davefiddes/Wugo-PCII-System-Board/pictures/system-board-back-high-res.jpeg

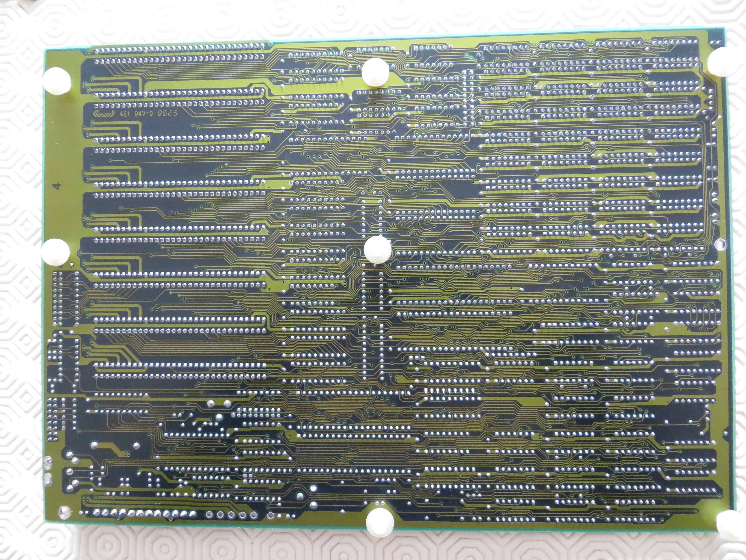
pictures/system-board-back-high-res.jpeg
