davefiddes/Wugo-PCII-System-Board/pictures/system-board-details-high-res.jpeg

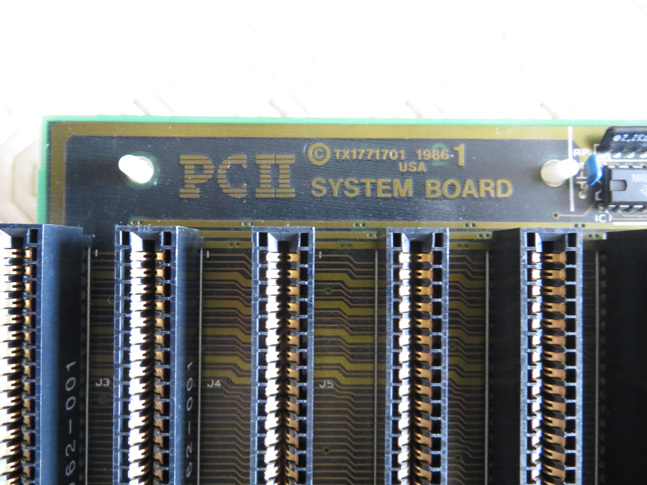
pictures/system-board-details-high-res.jpeg
