davefiddes/Wugo-PCII-System-Board/bus-arbitration.sch

## KiCad design bus-arbitration.sch (2020-07-20)

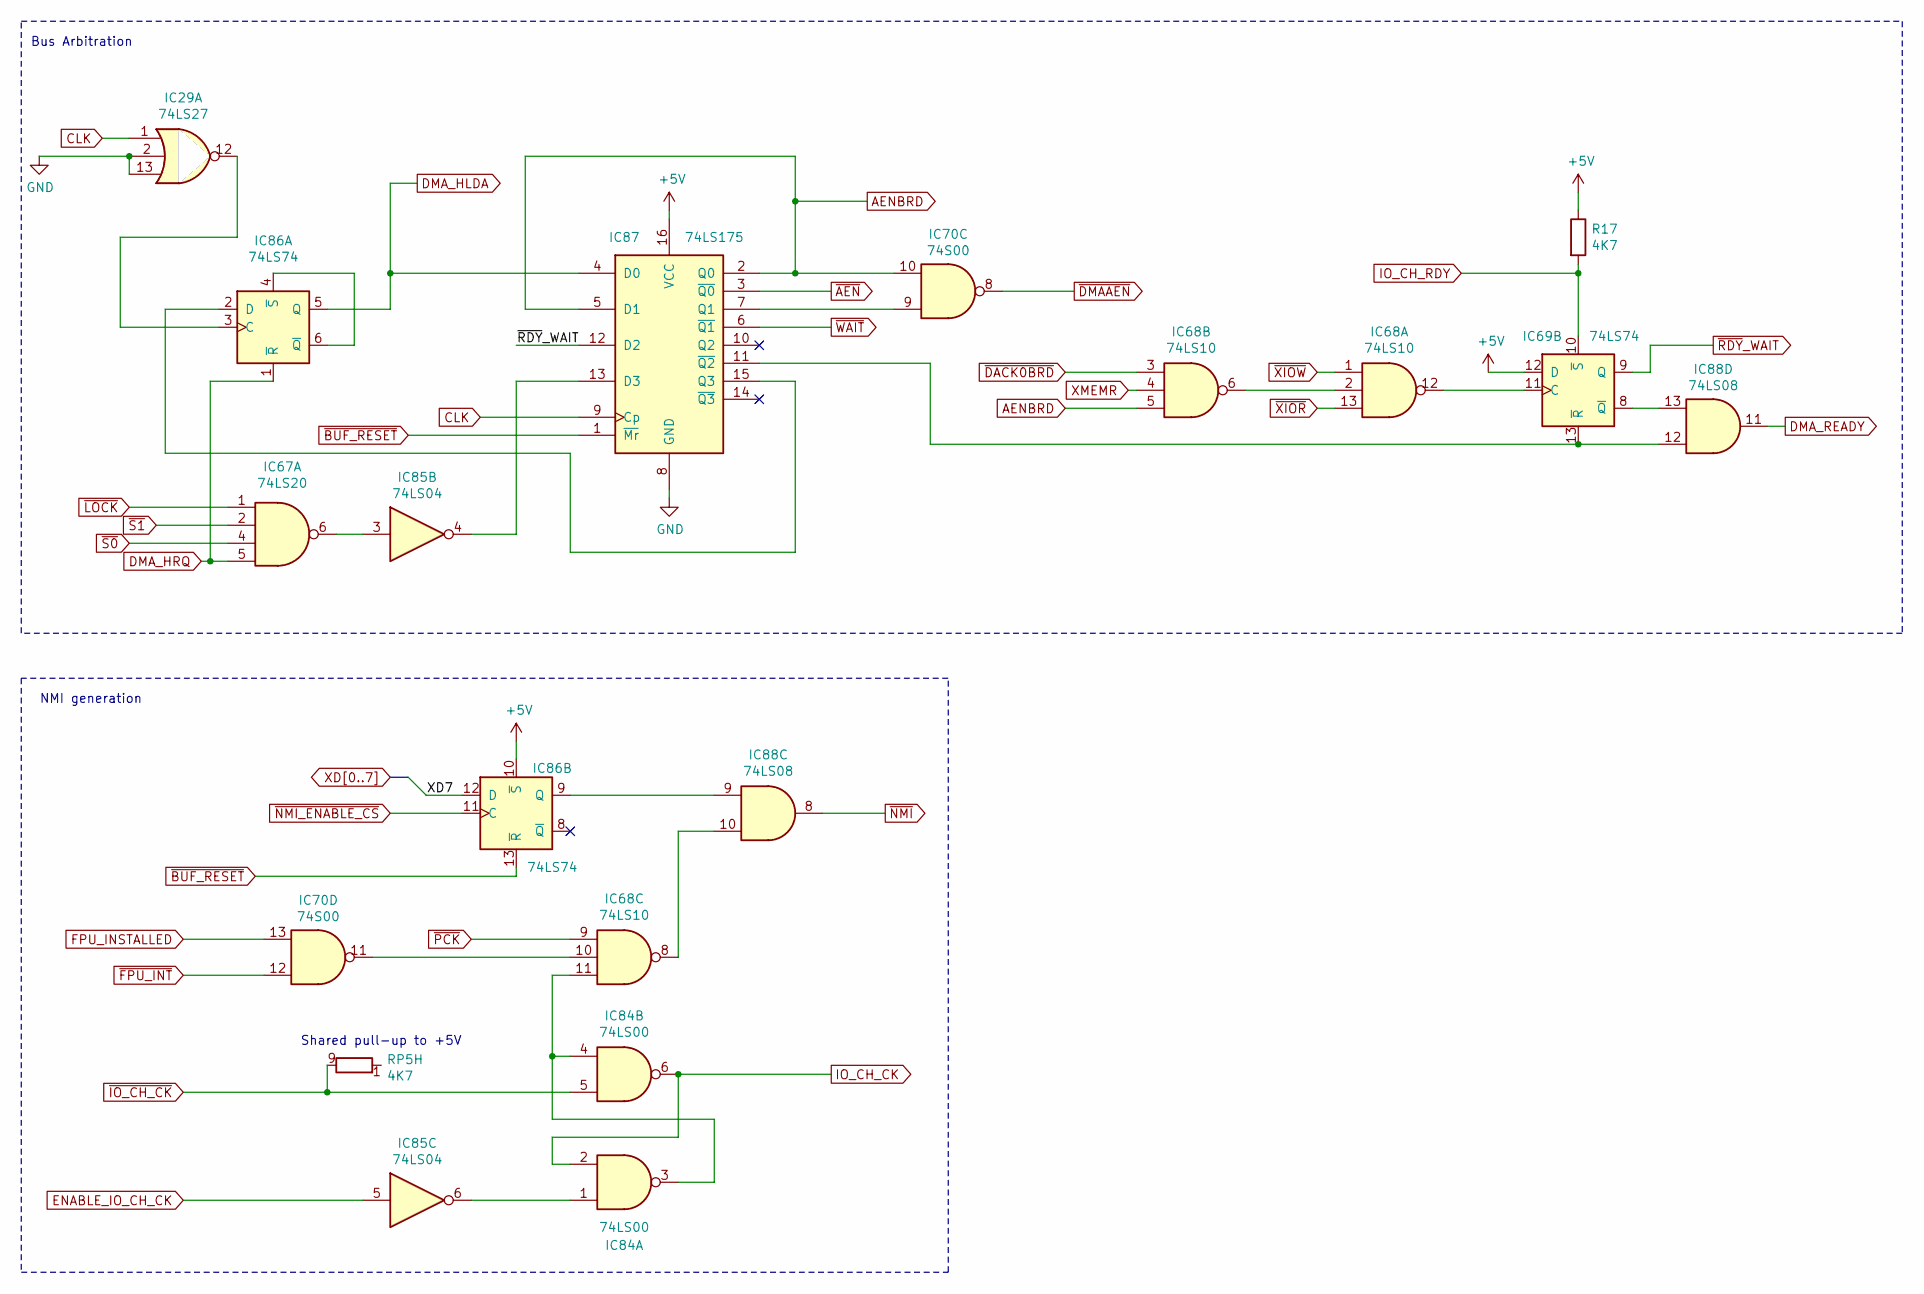
[picture p5: schematic bus-arbitration.sch]

Parts:
IC29: 74LS27
IC67: 74LS20
IC68: 74LS10
IC69, IC86: 74LS74
IC70: 74S00
IC84: 74LS00
IC85: 74LS04
IC87: 74LS175
IC88: 74LS08
R17: 4K7
RP5: 4K7; R_Array_SIP9

Connections:
+5V: IC69.12 (D), IC86.10 (~S), IC87.16 (VCC), R17.1
AENBRD: IC68.5, IC70.10, IC87.2 (Q0), IC87.5 (D1)
CLK: IC29.1, IC87.9 (Cp)
DMA_HLDA: IC86.5 (Q), IC87.4 (D0)
DMA_HRQ: IC67.5, IC86.1 (~R)
DMA_READY: IC88.11
ENABLE_IO_CH_CK: IC85.5
FPU_INSTALLED: IC70.13
GND: IC29.2, IC29.13, IC87.8 (GND)
IO_CH_CK: IC84.2, IC84.6
IO_CH_RDY: IC69.10 (~S), R17.2
unnamed: IC29.12, IC86.3 (C)
unnamed: IC67.6, IC85.3
unnamed: IC68.2, IC68.6
unnamed: IC68.8, IC88.10
unnamed: IC68.10, IC70.11
unnamed: IC68.11, IC84.3, IC84.4
unnamed: IC68.12, IC69.11 (C)
unnamed: IC69.8 (~Q), IC88.13
unnamed: IC69.13 (~R), IC87.11 (~Q2), IC88.12
unnamed: IC70.9, IC87.7 (Q1)
unnamed: IC84.1, IC85.6
unnamed: IC85.4, IC87.13 (D3)
unnamed: IC86.2 (D), IC87.15 (Q3)
unnamed: IC86.4 (~S), IC86.6 (~Q)
unnamed: IC86.9 (Q), IC88.9
XD7: IC86.12 (D)
XMEMR: IC68.4
~AEN~: IC87.3 (~Q0)
~BUF_RESET~: IC86.13 (~R), IC87.1 (~Mr)
~DACK0BRD~: IC68.3
~DMAAEN~: IC70.8
~FPU_INT~: IC70.12
~IO_CH_CK~: IC84.5, RP5.9 (R8.2)
~LOCK~: IC67.1
~NMI_ENABLE_CS~: IC86.11 (C)
~NMI~: IC88.8
~PCK~: IC68.9
~RDY~_WAIT: IC69.9 (Q), IC87.12 (D2)
~S0~: IC67.4
~S1~: IC67.2
~WAIT~: IC87.6 (~Q1)
~XIOR~: IC68.13
~XIOW~: IC68.1

Notes on the sheet:
NMI generation
Bus Arbitration
Shared pull-up to +5V
