davefiddes/Wugo-PCII-System-Board/clock.sch

## KiCad design clock.sch (2020-07-20)

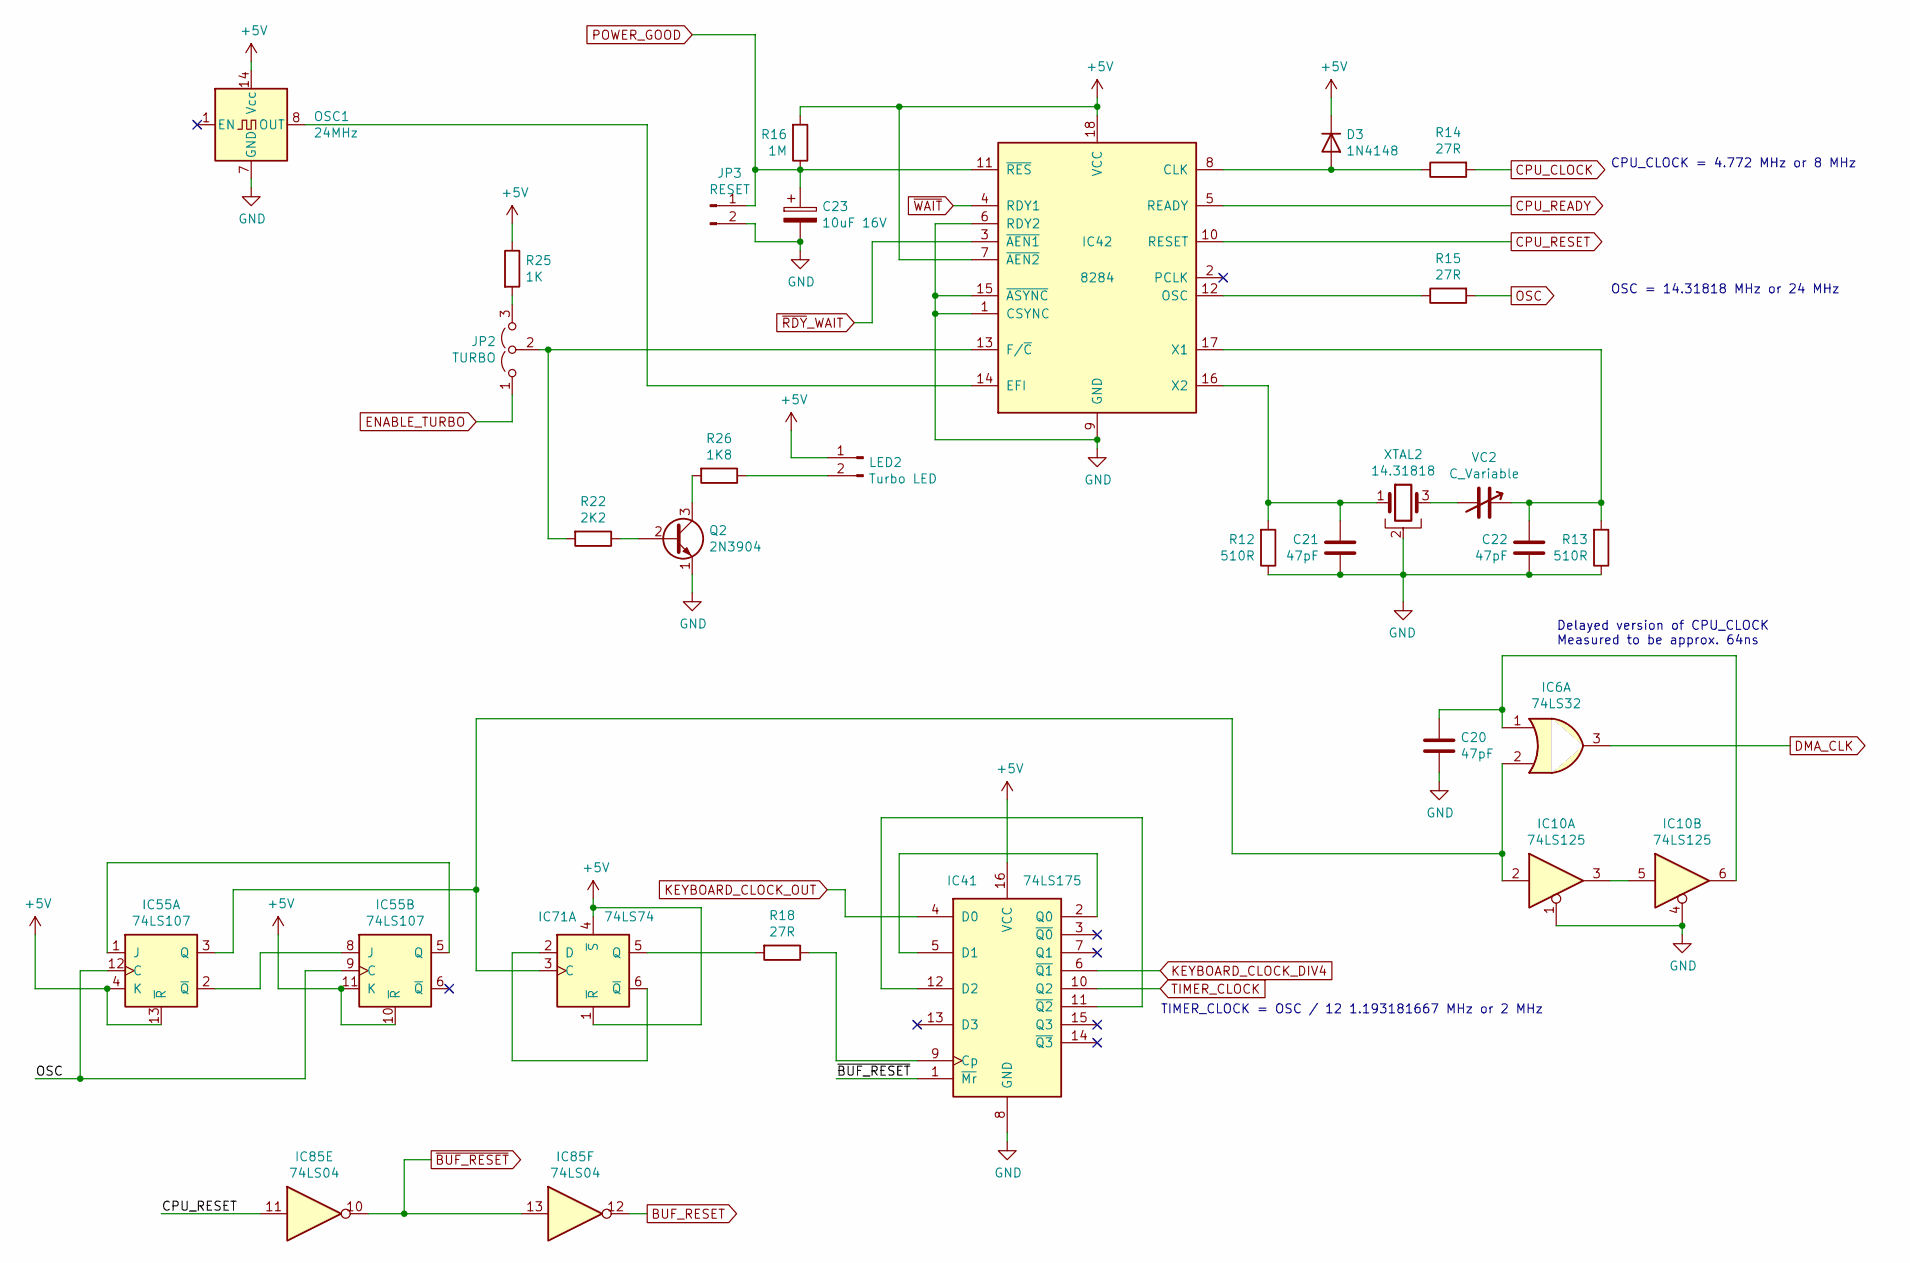
[picture p6: schematic clock.sch]

Parts:
C20, C21, C22: 47pF
C23: 10uF 16V
D3: 1N4148
IC6: 74LS32
IC10: 74LS125
IC41: 74LS175
IC42: 8284; DIP-18_W7.62mm
IC55: 74LS107
IC71: 74LS74
IC85: 74LS04
JP2: TURBO
JP3: RESET
LED2: Turbo LED
OSC1: 24MHz; Oscillator_DIP-14
Q2: 2N3904; TO-92_Inline
R12, R13: 510R
R14, R15, R18: 27R
R16: 1M
R22: 2K2
R25: 1K
R26: 1K8
VC2: C_Variable
XTAL2: 14.31818

Connections:
+5V: D3.1 (K), IC41.16 (VCC), IC42.7 (~AEN2~), IC42.18 (VCC), IC55.4 (K), IC55.10 (~R), IC55.11 (K), IC55.13 (~R), IC71.1 (~R), IC71.4 (~S), LED2.1, OSC1.14 (Vcc), R16.2, R25.1
BUF_RESET: IC85.12
CPU_CLOCK: R14.2
CPU_READY: IC42.5 (READY)
CPU_RESET: IC42.10 (RESET), IC85.11
DMA_CLK: IC6.3
ENABLE_TURBO: JP2.1 (A)
GND: C20.2, C21.2, C22.2, C23.2, IC10.1, IC10.4, IC41.8 (GND), IC42.1 (CSYNC), IC42.6 (RDY2), IC42.9 (GND), IC42.15 (~ASYNC~), JP3.2, OSC1.7 (GND), Q2.1 (E), R12.1, R13.1, XTAL2.2
KEYBOARD_CLOCK_DIV4: IC41.6 (~Q1)
KEYBOARD_CLOCK_OUT: IC41.4 (D0)
unnamed: C20.1, IC6.1, IC10.6
unnamed: C21.1, IC42.16 (X2), R12.2, XTAL2.1
unnamed: C22.1, IC42.17 (X1), R13.2, VC2.1
unnamed: D3.2 (A), IC42.8 (CLK), R14.1
unnamed: IC6.2, IC10.2, IC55.3 (Q), IC71.3 (C)
unnamed: IC10.3, IC10.5
unnamed: IC41.2 (Q0), IC41.5 (D1)
unnamed: IC41.9 (Cp), R18.1
unnamed: IC41.11 (~Q2), IC41.12 (D2)
unnamed: IC42.12 (OSC), R15.1
unnamed: IC42.13 (F/~C~), JP2.2 (C), R22.2
unnamed: IC42.14 (EFI), OSC1.8 (OUT)
unnamed: IC55.1 (J), IC55.5 (Q)
unnamed: IC55.2 (~Q), IC55.8 (J)
unnamed: IC71.2 (D), IC71.6 (~Q)
unnamed: IC71.5 (Q), R18.2
unnamed: JP2.3 (B), R25.2
unnamed: LED2.2, R26.1
unnamed: Q2.2 (B), R22.1
unnamed: Q2.3 (C), R26.2
unnamed: VC2.2, XTAL2.3
OSC: IC55.9 (C), IC55.12 (C), R15.2
POWER_GOOD: C23.1, IC42.11 (~RES~), JP3.1, R16.1
TIMER_CLOCK: IC41.10 (Q2)
~BUF_RESET~: IC41.1 (~Mr), IC85.10, IC85.13
~RDY~_WAIT: IC42.3 (~AEN1~)
~WAIT~: IC42.4 (RDY1)

Notes on the sheet:
TIMER_CLOCK = OSC / 12 1.193181667 MHz or 2 MHz
Delayed version of CPU_CLOCK Measured to be approx. 64ns
CPU_CLOCK = 4.772 MHz or 8 MHz
OSC = 14.31818 MHz or 24 MHz
