davefiddes/Wugo-PCII-System-Board/cpu.sch

## KiCad design cpu.sch (2020-07-20)

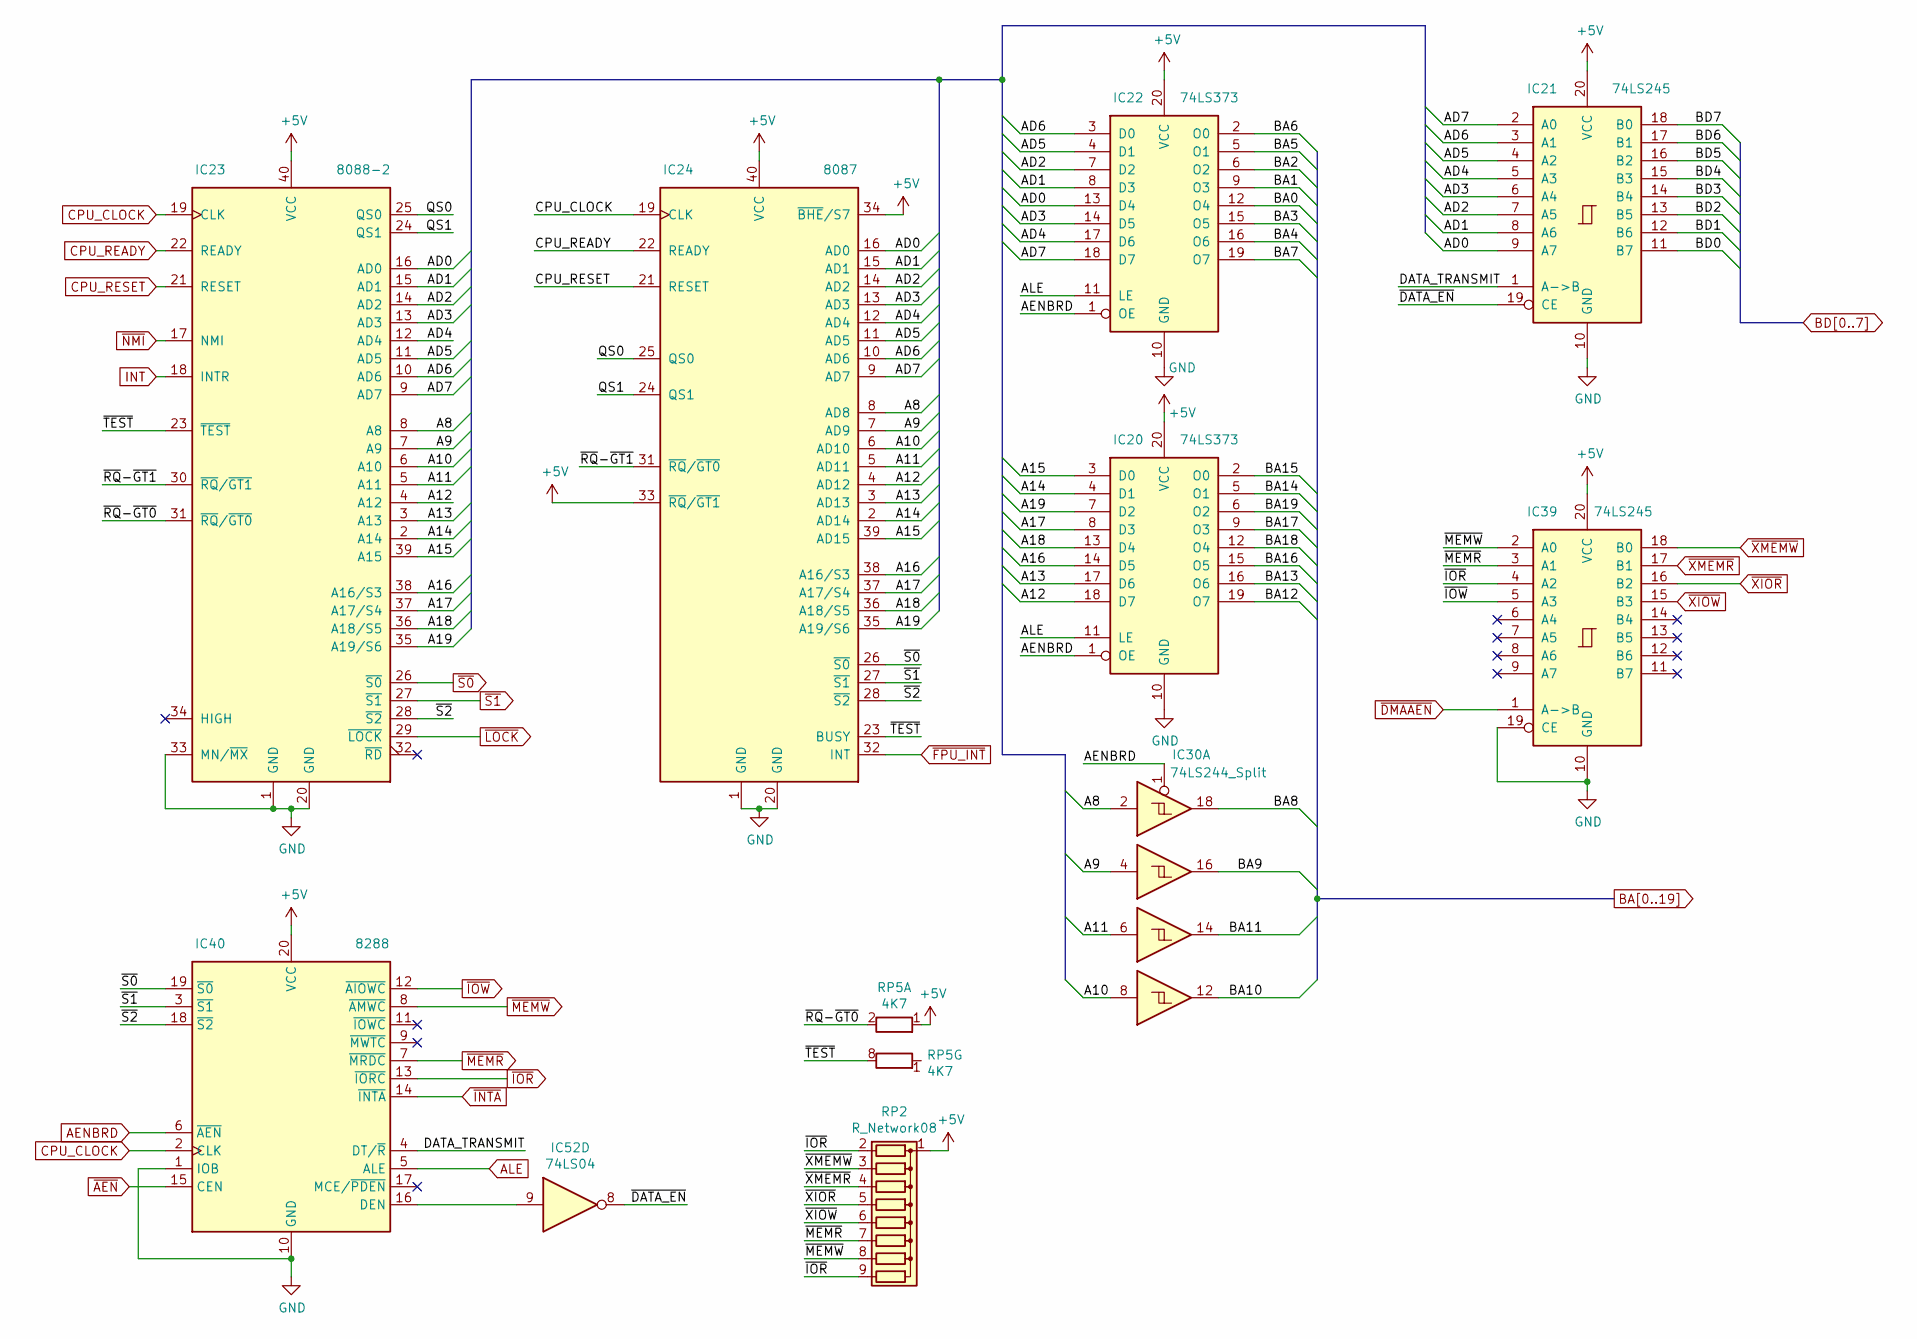
[picture p7: schematic cpu.sch]

Parts:
IC20, IC22: 74LS373
IC21, IC39: 74LS245
IC23: 8088-2; DIP-40_W15.24mm
IC24: 8087; DIP-40_W15.24mm
IC30: 74LS244_Split
IC40: 8288; DIP-20_W7.62mm
IC52: 74LS04
RP2: R_Network08; R_Array_SIP9
RP5: 4K7; R_Array_SIP9

Connections:
+5V: IC20.20 (VCC), IC21.20 (VCC), IC22.20 (VCC), IC23.40 (VCC), IC24.33 (~RQ~/~GT1~), IC24.34 (~BHE~/S7), IC24.40 (VCC), IC39.20 (VCC), IC40.20 (VCC), RP2.1 (common), RP5.1 (R1.1)
A8: IC23.8 (A8), IC24.8 (AD8), IC30.2
A9: IC23.7 (A9), IC24.7 (AD9), IC30.4
A10: IC23.6 (A10), IC24.6 (AD10), IC30.8
A11: IC23.5 (A11), IC24.5 (AD11), IC30.6
A12: IC20.18 (D7), IC23.4 (A12), IC24.4 (AD12)
A13: IC20.17 (D6), IC23.3 (A13), IC24.3 (AD13)
A14: IC20.4 (D1), IC23.2 (A14), IC24.2 (AD14)
A15: IC20.3 (D0), IC23.39 (A15), IC24.39 (AD15)
A16: IC20.14 (D5), IC23.38 (A16/S3), IC24.38 (A16/S3)
A17: IC20.8 (D3), IC23.37 (A17/S4), IC24.37 (A17/S4)
A18: IC20.13 (D4), IC23.36 (A18/S5), IC24.36 (A18/S5)
A19: IC20.7 (D2), IC23.35 (A19/S6), IC24.35 (A19/S6)
AD0: IC21.9 (A7), IC22.13 (D4), IC23.16 (AD0), IC24.16 (AD0)
AD1: IC21.8 (A6), IC22.8 (D3), IC23.15 (AD1), IC24.15 (AD1)
AD2: IC21.7 (A5), IC22.7 (D2), IC23.14 (AD2), IC24.14 (AD2)
AD3: IC21.6 (A4), IC22.14 (D5), IC23.13 (AD3), IC24.13 (AD3)
AD4: IC21.5 (A3), IC22.17 (D6), IC23.12 (AD4), IC24.12 (AD4)
AD5: IC21.4 (A2), IC22.4 (D1), IC23.11 (AD5), IC24.11 (AD5)
AD6: IC21.3 (A1), IC22.3 (D0), IC23.10 (AD6), IC24.10 (AD6)
AD7: IC21.2 (A0), IC22.18 (D7), IC23.9 (AD7), IC24.9 (AD7)
AENBRD: IC20.1 (OE), IC22.1 (OE), IC30.1, IC40.6 (~AEN~)
ALE: IC20.11 (LE), IC22.11 (LE), IC40.5 (ALE)
BA0: IC22.12 (O4)
BA1: IC22.9 (O3)
BA2: IC22.6 (O2)
BA3: IC22.15 (O5)
BA4: IC22.16 (O6)
BA5: IC22.5 (O1)
BA6: IC22.2 (O0)
BA7: IC22.19 (O7)
BA8: IC30.18
BA9: IC30.16
BA10: IC30.12
BA11: IC30.14
BA12: IC20.19 (O7)
BA13: IC20.16 (O6)
BA14: IC20.5 (O1)
BA15: IC20.2 (O0)
BA16: IC20.15 (O5)
BA17: IC20.9 (O3)
BA18: IC20.12 (O4)
BA19: IC20.6 (O2)
BD0: IC21.11 (B7)
BD1: IC21.12 (B6)
BD2: IC21.13 (B5)
BD3: IC21.14 (B4)
BD4: IC21.15 (B3)
BD5: IC21.16 (B2)
BD6: IC21.17 (B1)
BD7: IC21.18 (B0)
CPU_CLOCK: IC23.19 (CLK), IC24.19 (CLK), IC40.2 (CLK)
CPU_READY: IC23.22 (READY), IC24.22 (READY)
CPU_RESET: IC23.21 (RESET), IC24.21 (RESET)
DATA_TRANSMIT: IC21.1 (A->B), IC40.4 (DT/~R~)
GND: IC20.10 (GND), IC21.10 (GND), IC22.10 (GND), IC23.1 (GND), IC23.20 (GND), IC23.33 (MN/~MX~), IC24.1 (GND), IC24.20 (GND), IC39.10 (GND), IC39.19 (CE), IC40.1 (IOB), IC40.10 (GND)
INT: IC23.18 (INTR)
unnamed: IC40.16 (DEN), IC52.9
QS0: IC23.25 (QS0), IC24.25 (QS0)
QS1: IC23.24 (QS1), IC24.24 (QS1)
~AEN~: IC40.15 (CEN)
~DATA_EN~: IC21.19 (CE), IC52.8
~DMAAEN~: IC39.1 (A->B)
~FPU_INT~: IC24.32 (INT)
~INTA~: IC40.14 (~INTA~)
~IOR~: IC39.4 (A2), IC40.13 (~IORC~), RP2.2 (R1), RP2.9 (R8)
~IOW~: IC39.5 (A3), IC40.12 (~AIOWC~)
~LOCK~: IC23.29 (~LOCK~)
~MEMR~: IC39.3 (A1), IC40.7 (~MRDC~), RP2.7 (R6)
~MEMW~: IC39.2 (A0), IC40.8 (~AMWC~), RP2.8 (R7)
~NMI~: IC23.17 (NMI)
~RQ~-~GT0~: IC23.31 (~RQ~/~GT0~), RP5.2 (R1.2)
~RQ~-~GT1~: IC23.30 (~RQ~/~GT1~), IC24.31 (~RQ~/~GT0~)
~S0~: IC23.26 (~S0~), IC24.26 (~S0~), IC40.19 (~S0~)
~S1~: IC23.27 (~S1~), IC24.27 (~S1~), IC40.3 (~S1~)
~S2~: IC23.28 (~S2~), IC24.28 (~S2~), IC40.18 (~S2~)
~TEST~: IC23.23 (~TEST~), IC24.23 (BUSY), RP5.8 (R7.2)
~XIOR~: IC39.16 (B2), RP2.5 (R4)
~XIOW~: IC39.15 (B3), RP2.6 (R5)
~XMEMR~: IC39.17 (B1), RP2.4 (R3)
~XMEMW~: IC39.18 (B0), RP2.3 (R2)
