davefiddes/Wugo-PCII-System-Board/game-port.sch

## KiCad design game-port.sch (2020-07-20)

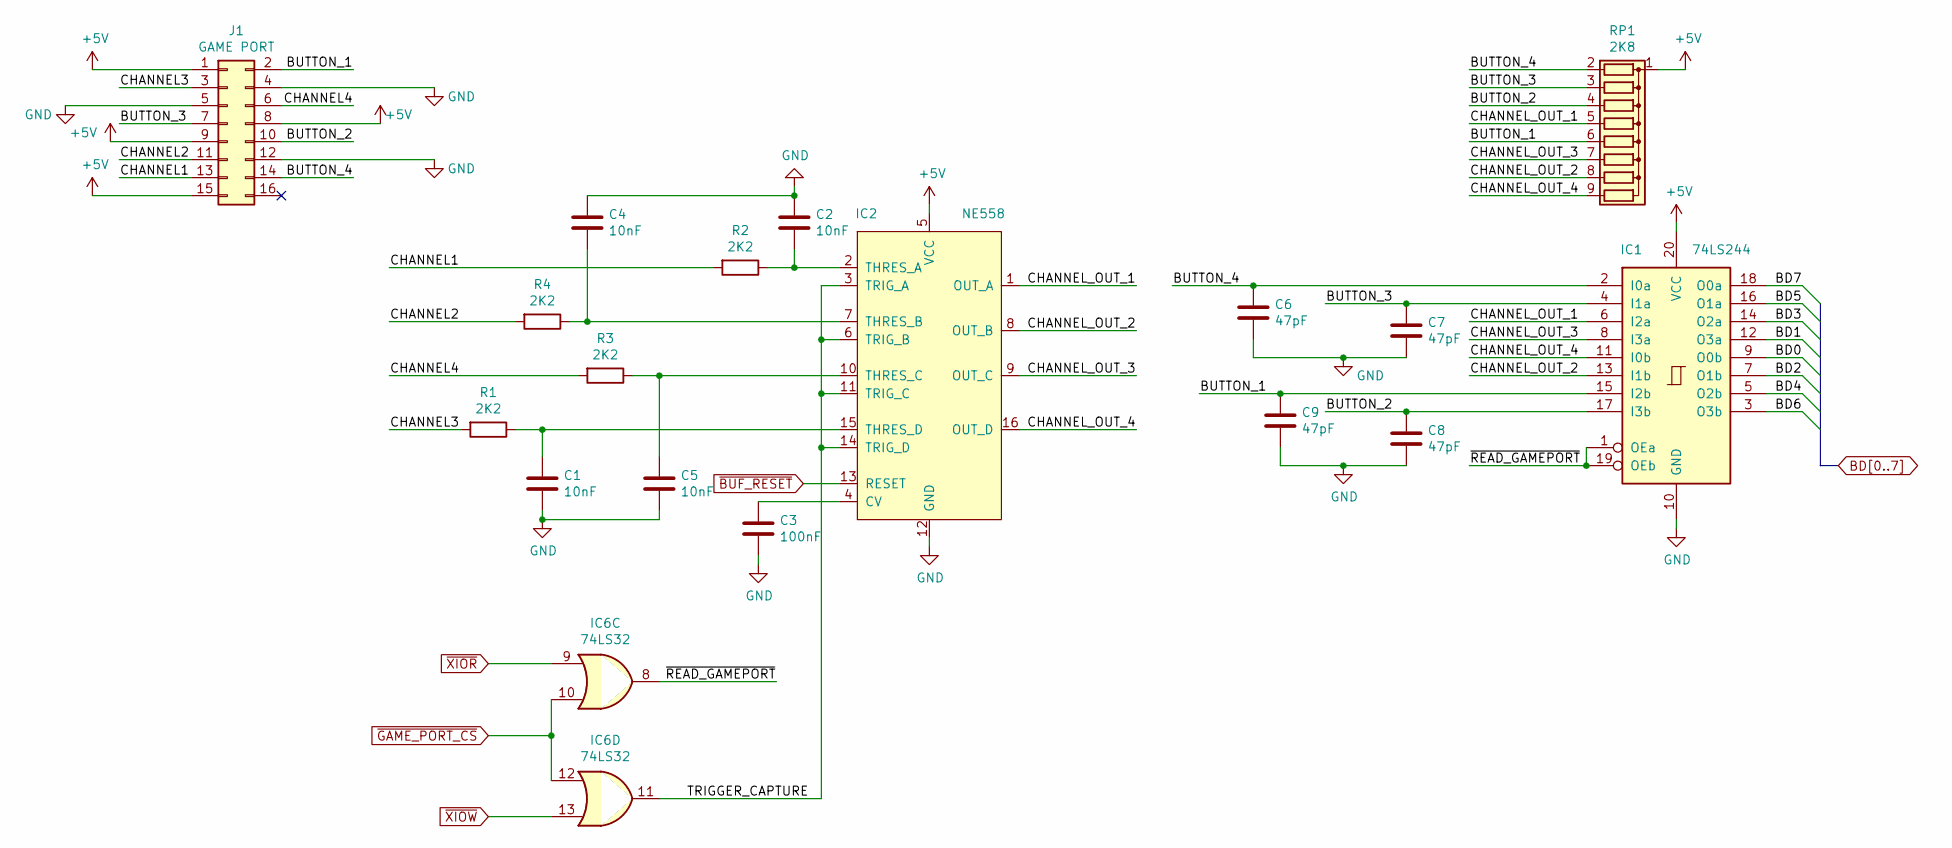
[picture p8: schematic game-port.sch]

Parts:
C1, C2, C4, C5: 10nF
C3: 100nF
C6, C7, C8, C9: 47pF
IC1: 74LS244
IC2: NE558
IC6: 74LS32
J1: GAME PORT
R1, R2, R3, R4: 2K2
RP1: 2K8; R_Array_SIP9

Connections:
+5V: IC1.20 (VCC), IC2.5 (VCC), J1.1, J1.8, J1.9, J1.15, RP1.1 (common)
BD0: IC1.9 (O0b)
BD1: IC1.12 (O3a)
BD2: IC1.7 (O1b)
BD3: IC1.14 (O2a)
BD4: IC1.5 (O2b)
BD5: IC1.16 (O1a)
BD6: IC1.3 (O3b)
BD7: IC1.18 (O0a)
BUTTON_1: C9.1, IC1.15 (I2b), J1.2, RP1.6 (R5)
BUTTON_2: C8.1, IC1.17 (I3b), J1.10, RP1.4 (R3)
BUTTON_3: C7.1, IC1.4 (I1a), J1.7, RP1.3 (R2)
BUTTON_4: C6.1, IC1.2 (I0a), J1.14, RP1.2 (R1)
CHANNEL1: J1.13, R2.2
CHANNEL2: J1.11, R4.2
CHANNEL3: J1.3, R1.2
CHANNEL4: J1.6, R3.2
CHANNEL_OUT_1: IC1.6 (I2a), IC2.1 (OUT_A), RP1.5 (R4)
CHANNEL_OUT_2: IC1.13 (I1b), IC2.8 (OUT_B), RP1.8 (R7)
CHANNEL_OUT_3: IC1.8 (I3a), IC2.9 (OUT_C), RP1.7 (R6)
CHANNEL_OUT_4: IC1.11 (I0b), IC2.16 (OUT_D), RP1.9 (R8)
GND: C1.2, C2.1, C3.2, C4.1, C5.2, C6.2, C7.2, C8.2, C9.2, IC1.10 (GND), IC2.12 (GND), J1.4, J1.5, J1.12
unnamed: C1.1, IC2.15 (THRES_D), R1.1
unnamed: C2.2, IC2.2 (THRES_A), R2.1
unnamed: C3.1, IC2.4 (CV)
unnamed: C4.2, IC2.7 (THRES_B), R4.1
unnamed: C5.1, IC2.10 (THRES_C), R3.1
TRIGGER_CAPTURE: IC2.3 (TRIG_A), IC2.6 (TRIG_B), IC2.11 (TRIG_C), IC2.14 (TRIG_D), IC6.11
~BUF_RESET~: IC2.13 (RESET)
~GAME_PORT_CS~: IC6.10, IC6.12
~READ_GAMEPORT~: IC1.1 (OEa), IC1.19 (OEb), IC6.8
~XIOR~: IC6.9
~XIOW~: IC6.13
