davefiddes/Wugo-PCII-System-Board/interrupts-dma.sch

## KiCad design interrupts-dma.sch (2020-07-20)

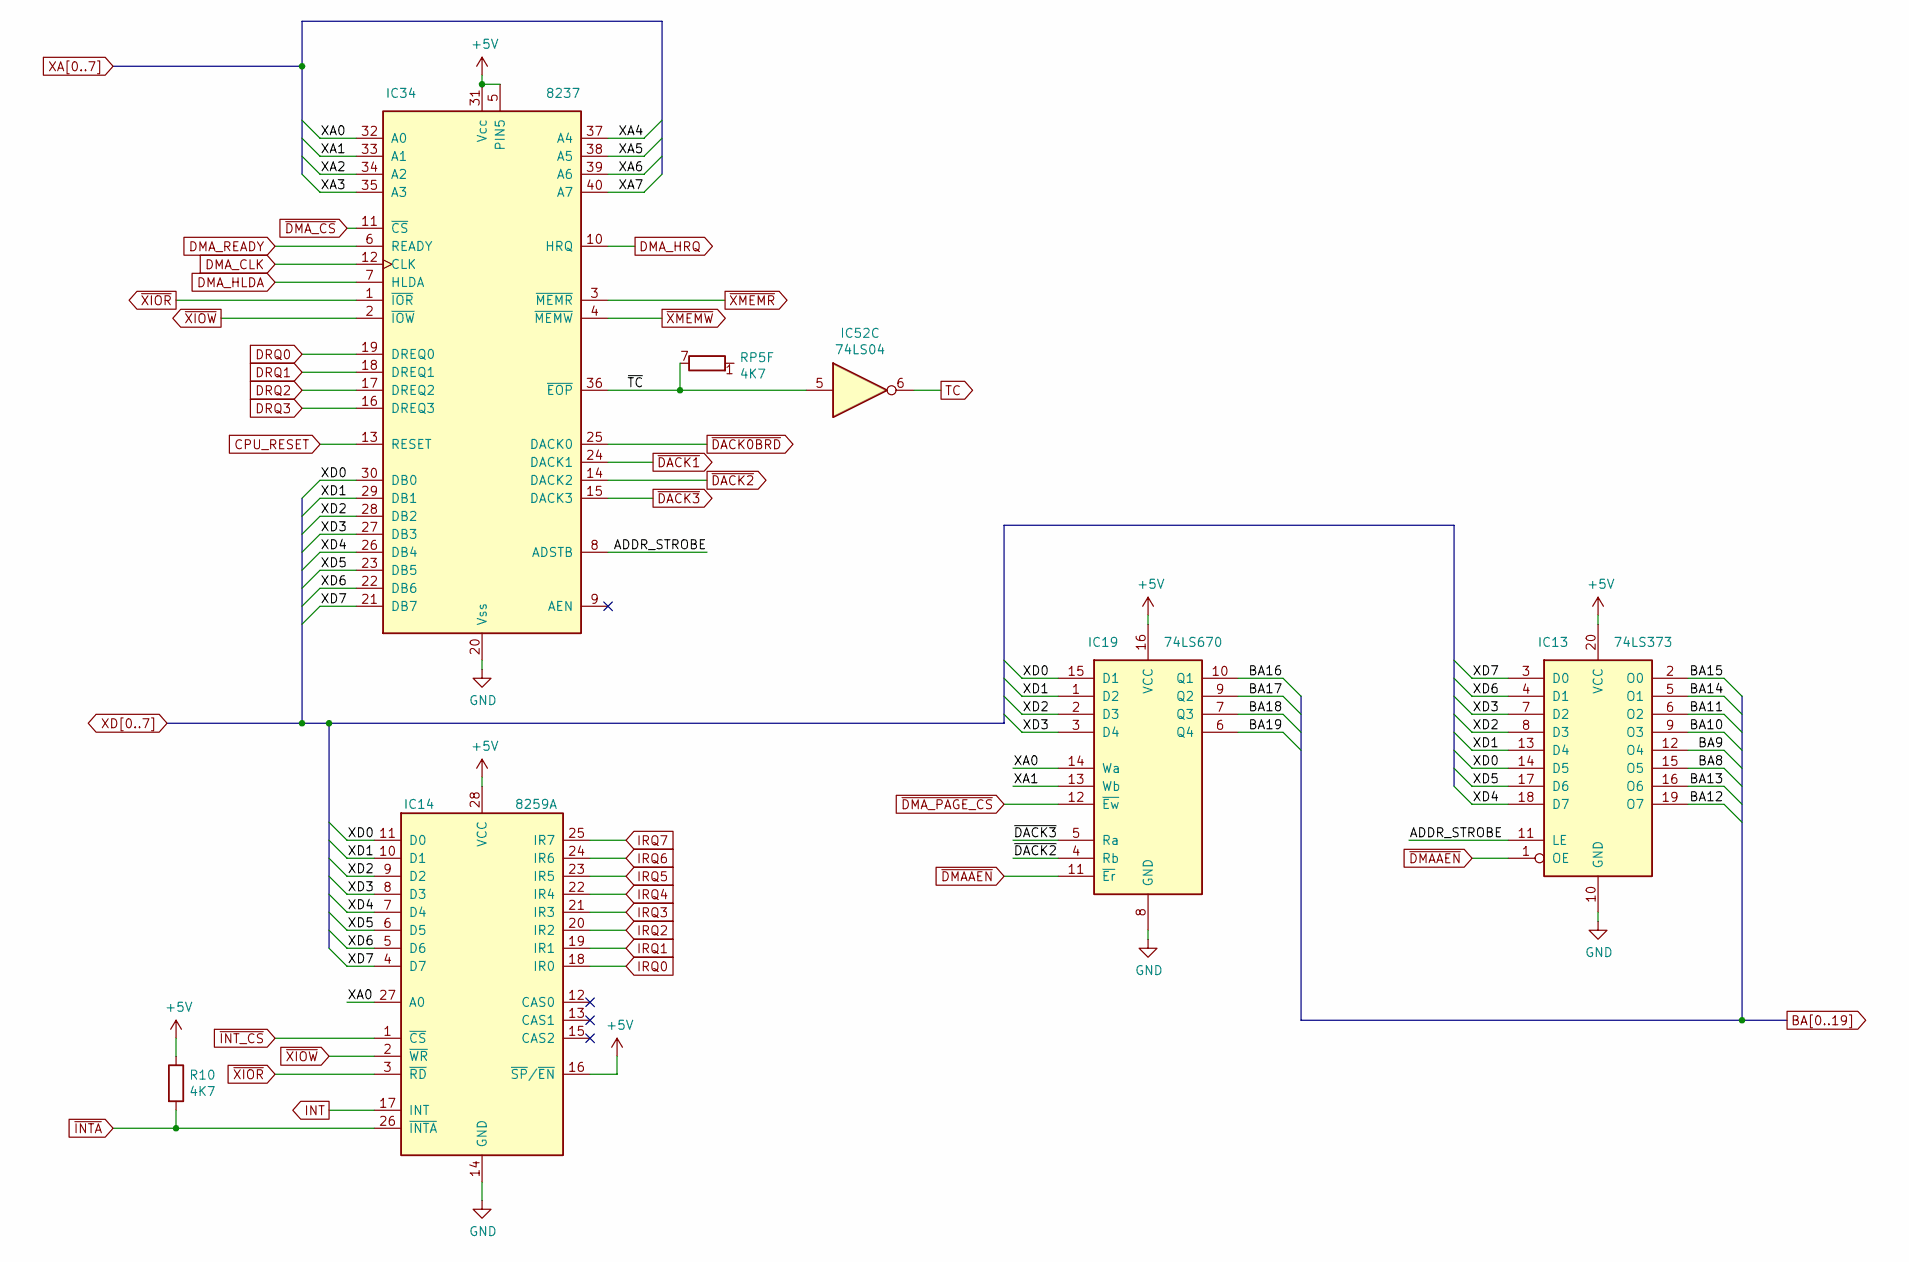
[picture p9: schematic interrupts-dma.sch]

Parts:
IC13: 74LS373
IC14: 8259A; DIP-28_W15.24mm
IC19: 74LS670
IC34: 8237; DIP-40_W15.24mm
IC52: 74LS04
R10: 4K7
RP5: 4K7; R_Array_SIP9

Connections:
+5V: IC13.20 (VCC), IC14.16 (~SP~/~EN~), IC14.28 (VCC), IC19.16 (VCC), IC34.5 (PIN5), IC34.31 (Vcc), R10.1
ADDR_STROBE: IC13.11 (LE), IC34.8 (ADSTB)
BA8: IC13.15 (O5)
BA9: IC13.12 (O4)
BA10: IC13.9 (O3)
BA11: IC13.6 (O2)
BA12: IC13.19 (O7)
BA13: IC13.16 (O6)
BA14: IC13.5 (O1)
BA15: IC13.2 (O0)
BA16: IC19.10 (Q1)
BA17: IC19.9 (Q2)
BA18: IC19.7 (Q3)
BA19: IC19.6 (Q4)
CPU_RESET: IC34.13 (RESET)
DMA_CLK: IC34.12 (CLK)
DMA_HLDA: IC34.7 (HLDA)
DMA_HRQ: IC34.10 (HRQ)
DMA_READY: IC34.6 (READY)
DRQ0: IC34.19 (DREQ0)
DRQ1: IC34.18 (DREQ1)
DRQ2: IC34.17 (DREQ2)
DRQ3: IC34.16 (DREQ3)
GND: IC13.10 (GND), IC14.14 (GND), IC19.8 (GND), IC34.20 (Vss)
INT: IC14.17 (INT)
IRQ0: IC14.18 (IR0)
IRQ1: IC14.19 (IR1)
IRQ2: IC14.20 (IR2)
IRQ3: IC14.21 (IR3)
IRQ4: IC14.22 (IR4)
IRQ5: IC14.23 (IR5)
IRQ6: IC14.24 (IR6)
IRQ7: IC14.25 (IR7)
TC: IC52.6
XA0: IC14.27 (A0), IC19.14 (Wa), IC34.32 (A0)
XA1: IC19.13 (Wb), IC34.33 (A1)
XA2: IC34.34 (A2)
XA3: IC34.35 (A3)
XA4: IC34.37 (A4)
XA5: IC34.38 (A5)
XA6: IC34.39 (A6)
XA7: IC34.40 (A7)
XD0: IC13.14 (D5), IC14.11 (D0), IC19.15 (D1), IC34.30 (DB0)
XD1: IC13.13 (D4), IC14.10 (D1), IC19.1 (D2), IC34.29 (DB1)
XD2: IC13.8 (D3), IC14.9 (D2), IC19.2 (D3), IC34.28 (DB2)
XD3: IC13.7 (D2), IC14.8 (D3), IC19.3 (D4), IC34.27 (DB3)
XD4: IC13.18 (D7), IC14.7 (D4), IC34.26 (DB4)
XD5: IC13.17 (D6), IC14.6 (D5), IC34.23 (DB5)
XD6: IC13.4 (D1), IC14.5 (D6), IC34.22 (DB6)
XD7: IC13.3 (D0), IC14.4 (D7), IC34.21 (DB7)
~DACK0BRD~: IC34.25 (DACK0)
~DACK1~: IC34.24 (DACK1)
~DACK2~: IC19.4 (Rb), IC34.14 (DACK2)
~DACK3~: IC19.5 (Ra), IC34.15 (DACK3)
~DMAAEN~: IC13.1 (OE), IC19.11 (~Er)
~DMA_CS~: IC34.11 (~CS~)
~DMA_PAGE_CS~: IC19.12 (~Ew)
~INTA~: IC14.26 (~INTA~), R10.2
~INT_CS~: IC14.1 (~CS~)
~TC~: IC34.36 (~EOP~), IC52.5, RP5.7 (R6.2)
~XIOR~: IC14.3 (~RD~), IC34.1 (~IOR~)
~XIOW~: IC14.2 (~WR~), IC34.2 (~IOW~)
~XMEMR~: IC34.3 (~MEMR~)
~XMEMW~: IC34.4 (~MEMW~)
