davefiddes/Wugo-PCII-System-Board/io-decode.sch

## KiCad design io-decode.sch (2020-05-30)

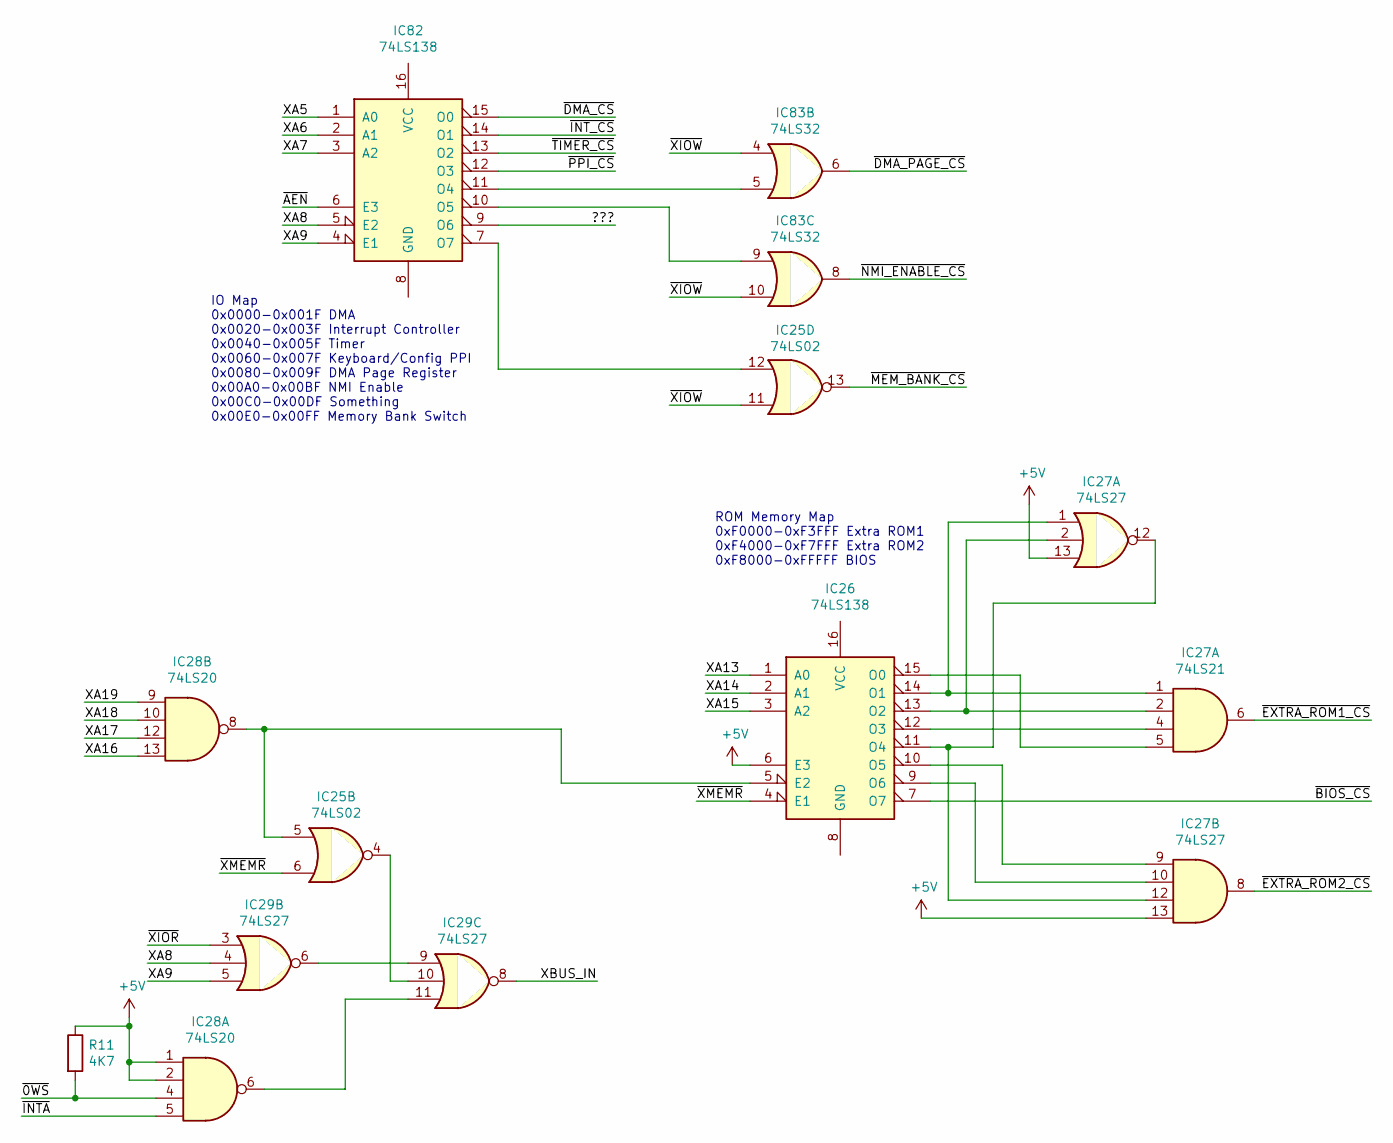
[picture p10: schematic io-decode.sch]

Parts:
IC25: 74LS02
IC26, IC82: 74LS138
IC27: 74LS21
IC28: 74LS20
IC29: 74LS27
IC83: 74LS32
R11: 4K7

Connections:
+5V: IC26.6 (E3), IC27.13, IC28.1, IC28.2, R11.1
???: IC82.9 (O6)
unnamed: IC25.4, IC29.10
unnamed: IC25.5, IC26.5 (E2), IC28.8
unnamed: IC25.12, IC82.7 (O7)
unnamed: IC26.9 (O6), IC27.10
unnamed: IC26.10 (O5), IC27.9
unnamed: IC26.11 (O4), IC27.12
unnamed: IC26.12 (O3), IC27.4
unnamed: IC26.13 (O2), IC27.2
unnamed: IC26.14 (O1), IC27.1
unnamed: IC26.15 (O0), IC27.5
unnamed: IC28.6, IC29.11
unnamed: IC29.6, IC29.9
unnamed: IC82.10 (O5), IC83.9
unnamed: IC82.11 (O4), IC83.5
XA5: IC82.1 (A0)
XA6: IC82.2 (A1)
XA7: IC82.3 (A2)
XA8: IC29.4, IC82.5 (E2)
XA9: IC29.5, IC82.4 (E1)
XA13: IC26.1 (A0)
XA14: IC26.2 (A1)
XA15: IC26.3 (A2)
XA16: IC28.13
XA17: IC28.12
XA18: IC28.10
XA19: IC28.9
XBUS_IN: IC29.8
~0WS~: IC28.4, R11.2
~AEN~: IC82.6 (E3)
~BIOS_CS~: IC26.7 (O7)
~DMA_CS~: IC82.15 (O0)
~DMA_PAGE_CS~: IC83.6
~EXTRA_ROM1_CS~: IC27.6
~EXTRA_ROM2_CS~: IC27.8
~INTA~: IC28.5
~INT_CS~: IC82.14 (O1)
~MEM_BANK_CS~: IC25.13
~NMI_ENABLE_CS~: IC83.8
~PPI_CS~: IC82.12 (O3)
~TIMER_CS~: IC82.13 (O2)
~XIOR~: IC29.3
~XIOW~: IC25.11, IC83.4, IC83.10
~XMEMR~: IC25.6, IC26.4 (E1)

Notes on the sheet:
ROM Memory Map 0xF0000-0xF3FFF Extra ROM1 0xF4000-0xF7FFF Extra ROM2 0xF8000-0xFFFFF BIOS
IO Map 0x0000-0x001F DMA 0x0020-0x003F Interrupt Controller 0x0040-0x005F Timer 0x0060-0x007F Keyboard/Config PPI 0x0080-0x009F DMA Page Register 0x00A0-0x00BF NMI Enable 0x00C0-0x00DF Something 0x00E0-0x00FF Memory Bank Switch
