davefiddes/Wugo-PCII-System-Board/io-rom-decode.sch

## KiCad design io-rom-decode.sch (2020-07-20)

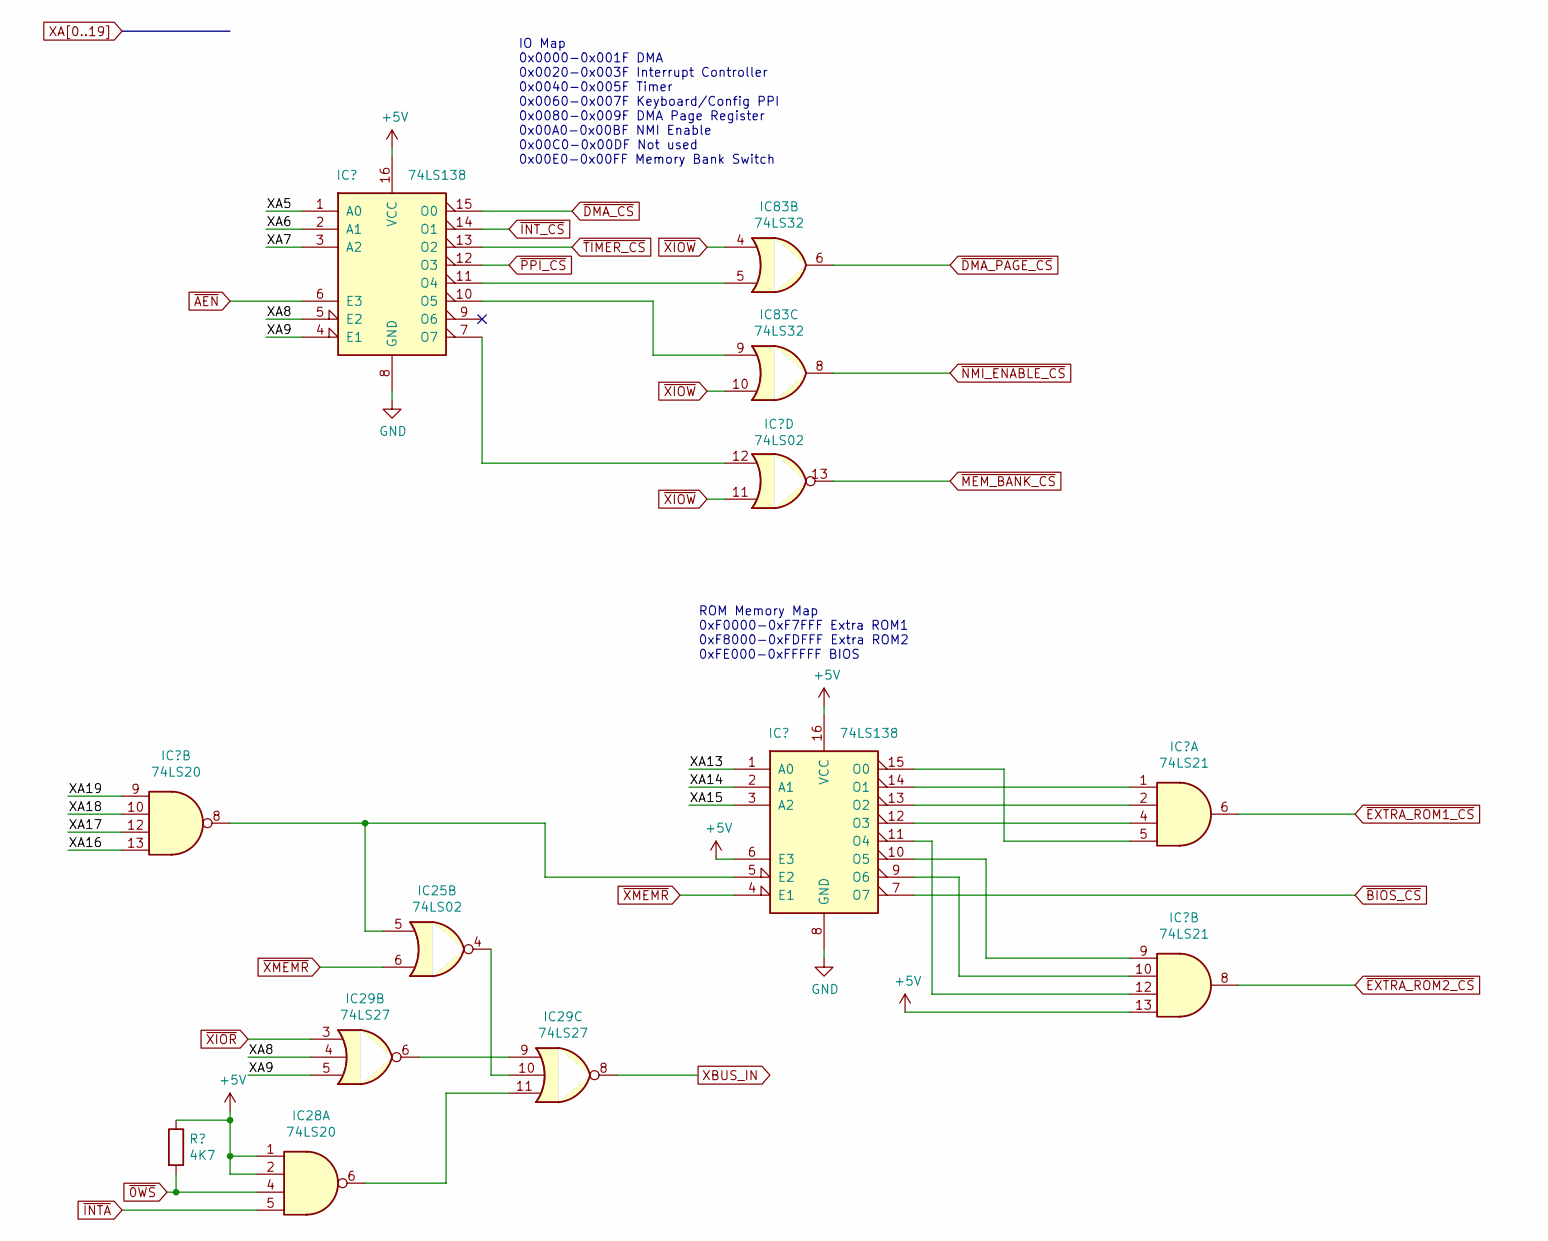
[picture p11: schematic io-rom-decode.sch]

Parts:
IC25: 74LS02
IC28: 74LS20
IC29: 74LS27
IC83: 74LS32

Connections:
+5V: IC28.1, IC28.2
unnamed: IC25.4, IC29.10
unnamed: IC28.6, IC29.11
unnamed: IC29.6, IC29.9
XA8: IC29.4
XA9: IC29.5
XBUS_IN: IC29.8
~0WS~: IC28.4
~DMA_PAGE_CS~: IC83.6
~INTA~: IC28.5
~NMI_ENABLE_CS~: IC83.8
~XIOR~: IC29.3
~XIOW~: IC83.4, IC83.10
~XMEMR~: IC25.6

Notes on the sheet:
ROM Memory Map 0xF0000-0xF7FFF Extra ROM1 0xF8000-0xFDFFF Extra ROM2 0xFE000-0xFFFFF BIOS
IO Map 0x0000-0x001F DMA 0x0020-0x003F Interrupt Controller 0x0040-0x005F Timer 0x0060-0x007F Keyboard/Config PPI 0x0080-0x009F DMA Page Register 0x00A0-0x00BF NMI Enable 0x00C0-0x00DF Not used 0x00E0-0x00FF Memory Bank Switch
