davefiddes/Wugo-PCII-System-Board/isa-bus.sch

## KiCad design isa-bus.sch (2020-07-20)

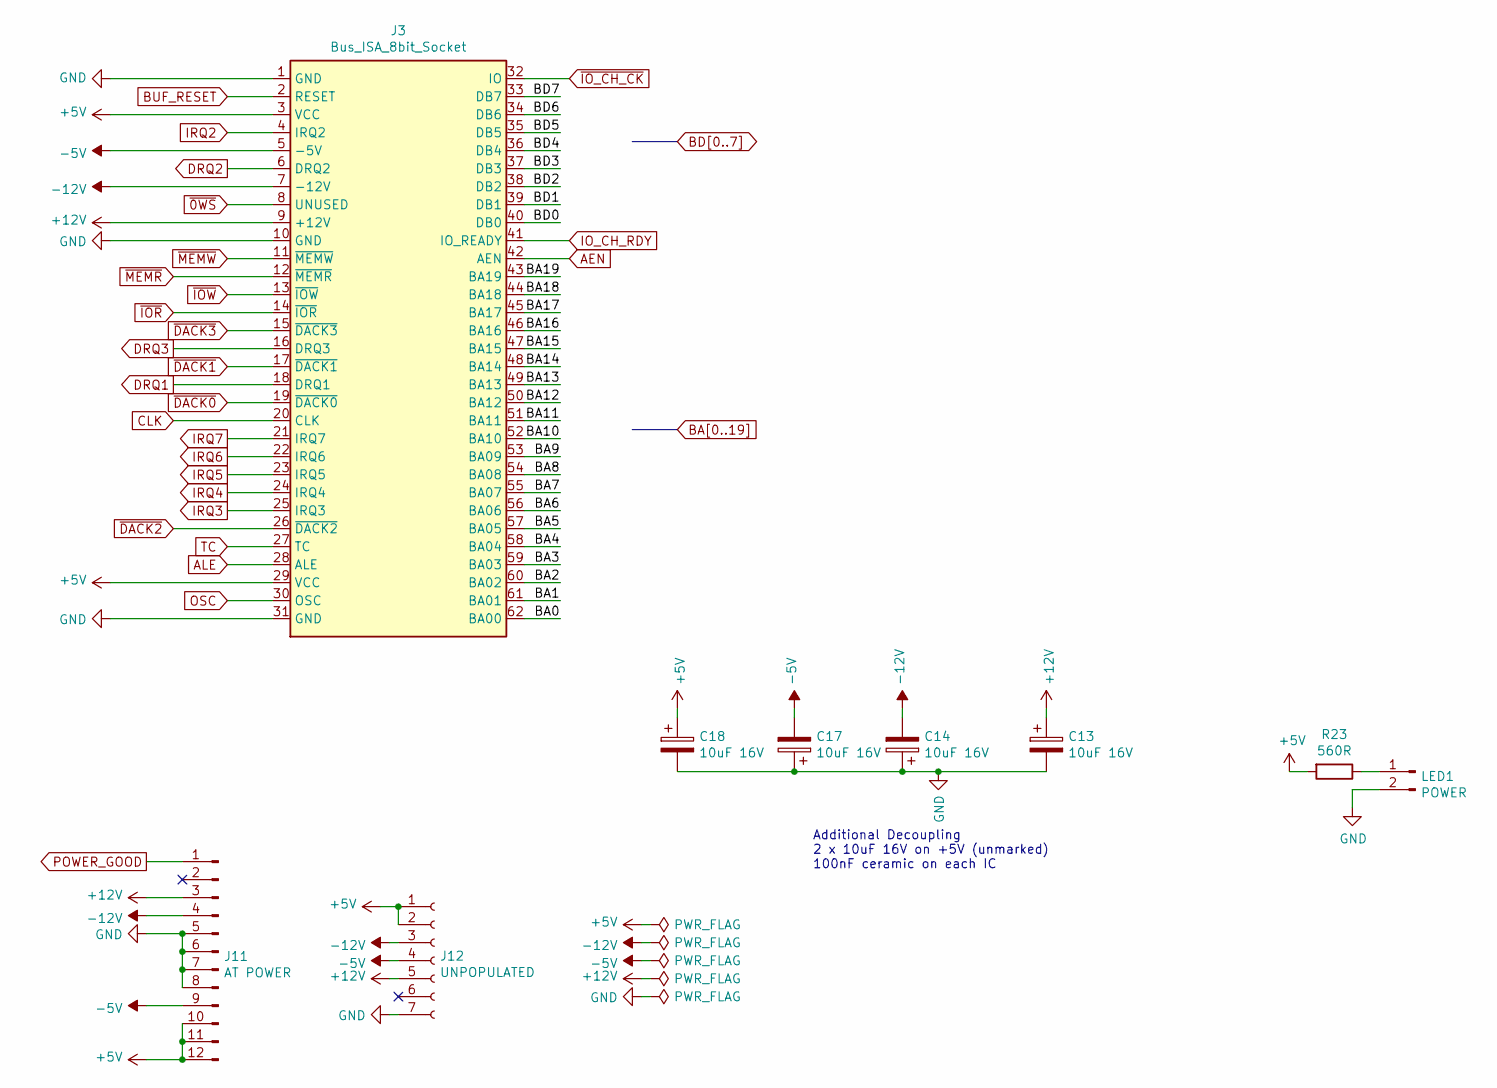
[picture p12: schematic isa-bus.sch]

Parts:
C13, C14, C17, C18: 10uF 16V
J3: Bus_ISA_8bit_Socket
J11: AT POWER
J12: UNPOPULATED
LED1: POWER
R23: 560R

Connections:
+5V: C18.1, J3.3 (VCC), J3.29 (VCC), J11.10, J11.11, J11.12, J12.1, J12.2, R23.2
+12V: C13.1, J3.9 (+12V), J11.3, J12.5
-5V: C17.2, J3.5 (-5V), J11.9, J12.4
-12V: C14.2, J3.7 (-12V), J11.4, J12.3
AEN: J3.42 (AEN)
ALE: J3.28 (ALE)
BA0: J3.62 (BA00)
BA1: J3.61 (BA01)
BA2: J3.60 (BA02)
BA3: J3.59 (BA03)
BA4: J3.58 (BA04)
BA5: J3.57 (BA05)
BA6: J3.56 (BA06)
BA7: J3.55 (BA07)
BA8: J3.54 (BA08)
BA9: J3.53 (BA09)
BA10: J3.52 (BA10)
BA11: J3.51 (BA11)
BA12: J3.50 (BA12)
BA13: J3.49 (BA13)
BA14: J3.48 (BA14)
BA15: J3.47 (BA15)
BA16: J3.46 (BA16)
BA17: J3.45 (BA17)
BA18: J3.44 (BA18)
BA19: J3.43 (BA19)
BD0: J3.40 (DB0)
BD1: J3.39 (DB1)
BD2: J3.38 (DB2)
BD3: J3.37 (DB3)
BD4: J3.36 (DB4)
BD5: J3.35 (DB5)
BD6: J3.34 (DB6)
BD7: J3.33 (DB7)
BUF_RESET: J3.2 (RESET)
CLK: J3.20 (CLK)
DRQ1: J3.18 (DRQ1)
DRQ2: J3.6 (DRQ2)
DRQ3: J3.16 (DRQ3)
GND: C13.2, C14.1, C17.1, C18.2, J3.1 (GND), J3.10 (GND), J3.31 (GND), J11.5, J11.6, J11.7, J11.8, J12.7, LED1.2
IO_CH_RDY: J3.41 (IO_READY)
IRQ2: J3.4 (IRQ2)
IRQ3: J3.25 (IRQ3)
IRQ4: J3.24 (IRQ4)
IRQ5: J3.23 (IRQ5)
IRQ6: J3.22 (IRQ6)
IRQ7: J3.21 (IRQ7)
unnamed: LED1.1, R23.1
OSC: J3.30 (OSC)
POWER_GOOD: J11.1
TC: J3.27 (TC)
~0WS~: J3.8 (UNUSED)
~DACK0~: J3.19 (~DACK0)
~DACK1~: J3.17 (~DACK1)
~DACK2~: J3.26 (~DACK2)
~DACK3~: J3.15 (~DACK3)
~IOR~: J3.14 (~IOR)
~IOW~: J3.13 (~IOW)
~IO_CH_CK~: J3.32 (IO)
~MEMR~: J3.12 (~MEMR)
~MEMW~: J3.11 (~MEMW)

Notes on the sheet:
Additional Decoupling 2 x 10uF 16V on +5V (unmarked) 100nF ceramic on each IC
