davefiddes/Wugo-PCII-System-Board/keyboard.sch

## KiCad design keyboard.sch (2020-07-20)

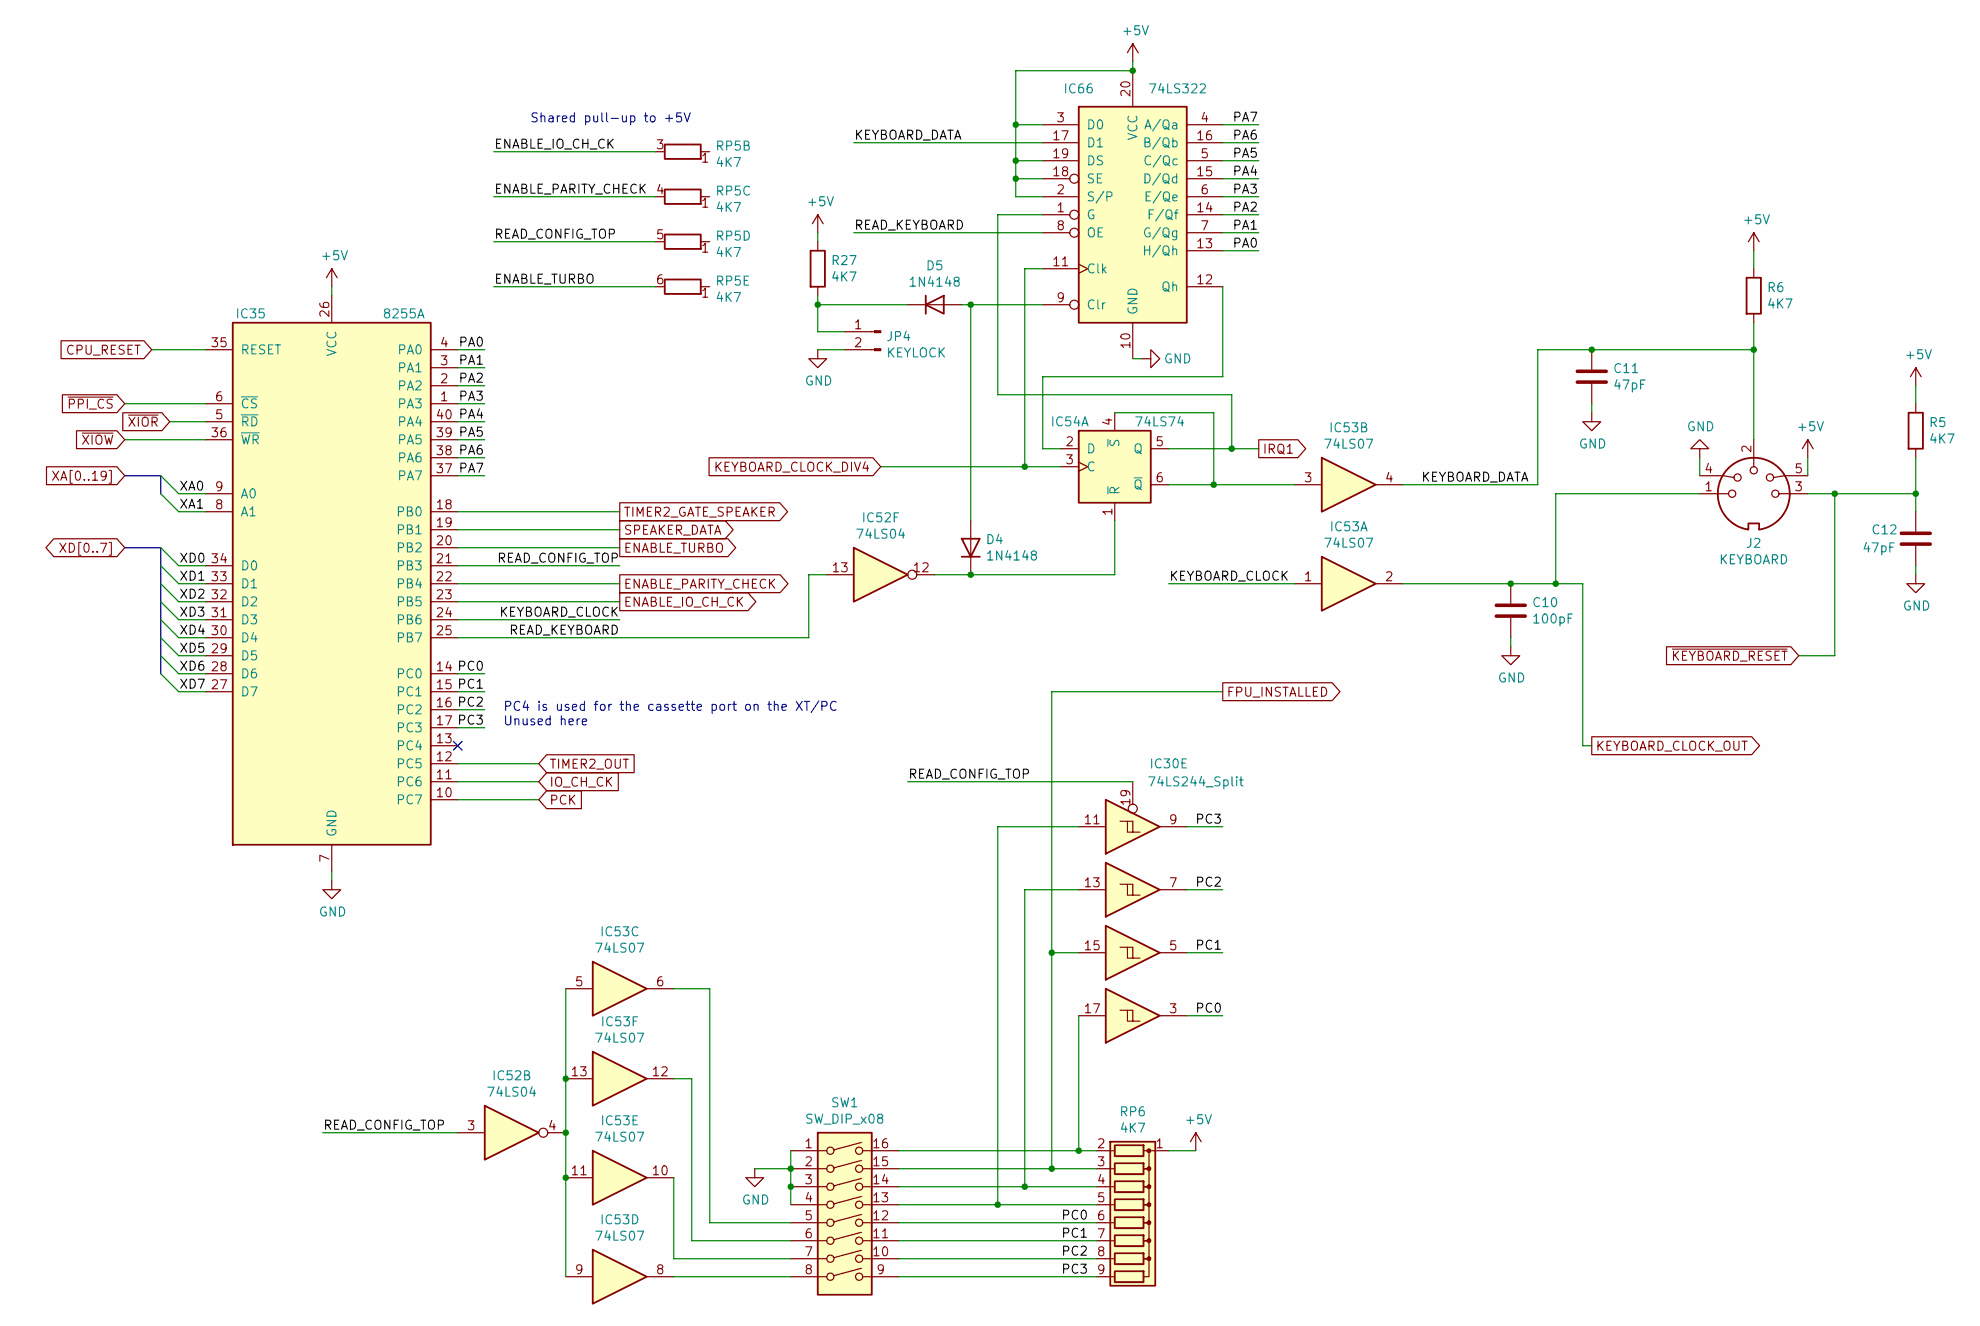
[picture p13: schematic keyboard.sch]

Parts:
C10: 100pF
C11, C12: 47pF
D4, D5: 1N4148
IC30: 74LS244_Split
IC35: 8255A; DIP-40_W15.24mm
IC52: 74LS04
IC53: 74LS07
IC54: 74LS74
IC66: 74LS322
J2: KEYBOARD
JP4: KEYLOCK
R5, R6, R27: 4K7
RP5, RP6: 4K7; R_Array_SIP9
SW1: SW_DIP_x08

Connections:
+5V: IC35.26 (VCC), IC66.2 (S/P), IC66.3 (D0), IC66.18 (SE), IC66.19 (DS), IC66.20 (VCC), J2.5, R5.1, R6.1, R27.1, RP6.1 (common)
CPU_RESET: IC35.35 (RESET)
ENABLE_IO_CH_CK: IC35.23 (PB5), RP5.3 (R2.2)
ENABLE_PARITY_CHECK: IC35.22 (PB4), RP5.4 (R3.2)
ENABLE_TURBO: IC35.20 (PB2), RP5.6 (R5.2)
FPU_INSTALLED: IC30.15, RP6.3 (R2), SW1.15
GND: C10.2, C11.2, C12.2, IC35.7 (GND), IC66.10 (GND), J2.4, JP4.2, SW1.1, SW1.2, SW1.3, SW1.4
IO_CH_CK: IC35.11 (PC6)
IRQ1: IC54.5 (Q), IC66.1 (G)
KEYBOARD_CLOCK: IC35.24 (PB6), IC53.1
KEYBOARD_CLOCK_DIV4: IC54.3 (C), IC66.11 (Clk)
KEYBOARD_CLOCK_OUT: C10.1, IC53.2, J2.1
KEYBOARD_DATA: C11.1, IC53.4, IC66.17 (D1), J2.2, R6.2
unnamed: D4.1 (K), IC52.12, IC54.1 (~R)
unnamed: D4.2 (A), D5.2 (A), IC66.9 (Clr)
unnamed: D5.1 (K), JP4.1, R27.2
unnamed: IC30.11, RP6.5 (R4), SW1.13
unnamed: IC30.13, RP6.4 (R3), SW1.14
unnamed: IC30.17, RP6.2 (R1), SW1.16
unnamed: IC52.4, IC53.5, IC53.9, IC53.11, IC53.13
unnamed: IC53.3, IC54.4 (~S), IC54.6 (~Q)
unnamed: IC53.6, SW1.5
unnamed: IC53.8, SW1.8
unnamed: IC53.10, SW1.7
unnamed: IC53.12, SW1.6
unnamed: IC54.2 (D), IC66.12 (Qh)
PA0: IC35.4 (PA0), IC66.13 (H/Qh)
PA1: IC35.3 (PA1), IC66.7 (G/Qg)
PA2: IC35.2 (PA2), IC66.14 (F/Qf)
PA3: IC35.1 (PA3), IC66.6 (E/Qe)
PA4: IC35.40 (PA4), IC66.15 (D/Qd)
PA5: IC35.39 (PA5), IC66.5 (C/Qc)
PA6: IC35.38 (PA6), IC66.16 (B/Qb)
PA7: IC35.37 (PA7), IC66.4 (A/Qa)
PC0: IC30.3, IC35.14 (PC0), RP6.6 (R5), SW1.12
PC1: IC30.5, IC35.15 (PC1), RP6.7 (R6), SW1.11
PC2: IC30.7, IC35.16 (PC2), RP6.8 (R7), SW1.10
PC3: IC30.9, IC35.17 (PC3), RP6.9 (R8), SW1.9
PCK: IC35.10 (PC7)
READ_CONFIG_TOP: IC30.19, IC35.21 (PB3), IC52.3, RP5.5 (R4.2)
READ_KEYBOARD: IC35.25 (PB7), IC52.13, IC66.8 (OE)
SPEAKER_DATA: IC35.19 (PB1)
TIMER2_GATE_SPEAKER: IC35.18 (PB0)
TIMER2_OUT: IC35.12 (PC5)
XA0: IC35.9 (A0)
XA1: IC35.8 (A1)
XD0: IC35.34 (D0)
XD1: IC35.33 (D1)
XD2: IC35.32 (D2)
XD3: IC35.31 (D3)
XD4: IC35.30 (D4)
XD5: IC35.29 (D5)
XD6: IC35.28 (D6)
XD7: IC35.27 (D7)
~KEYBOARD_RESET~: C12.1, J2.3, R5.2
~PPI_CS~: IC35.6 (~CS~)
~XIOR~: IC35.5 (~RD~)
~XIOW~: IC35.36 (~WR~)

Notes on the sheet:
PC4 is used for the cassette port on the XT/PC Unused here
Shared pull-up to +5V
