davefiddes/Wugo-PCII-System-Board/memory-drive.sch

## KiCad design memory-drive.sch (2020-07-20)

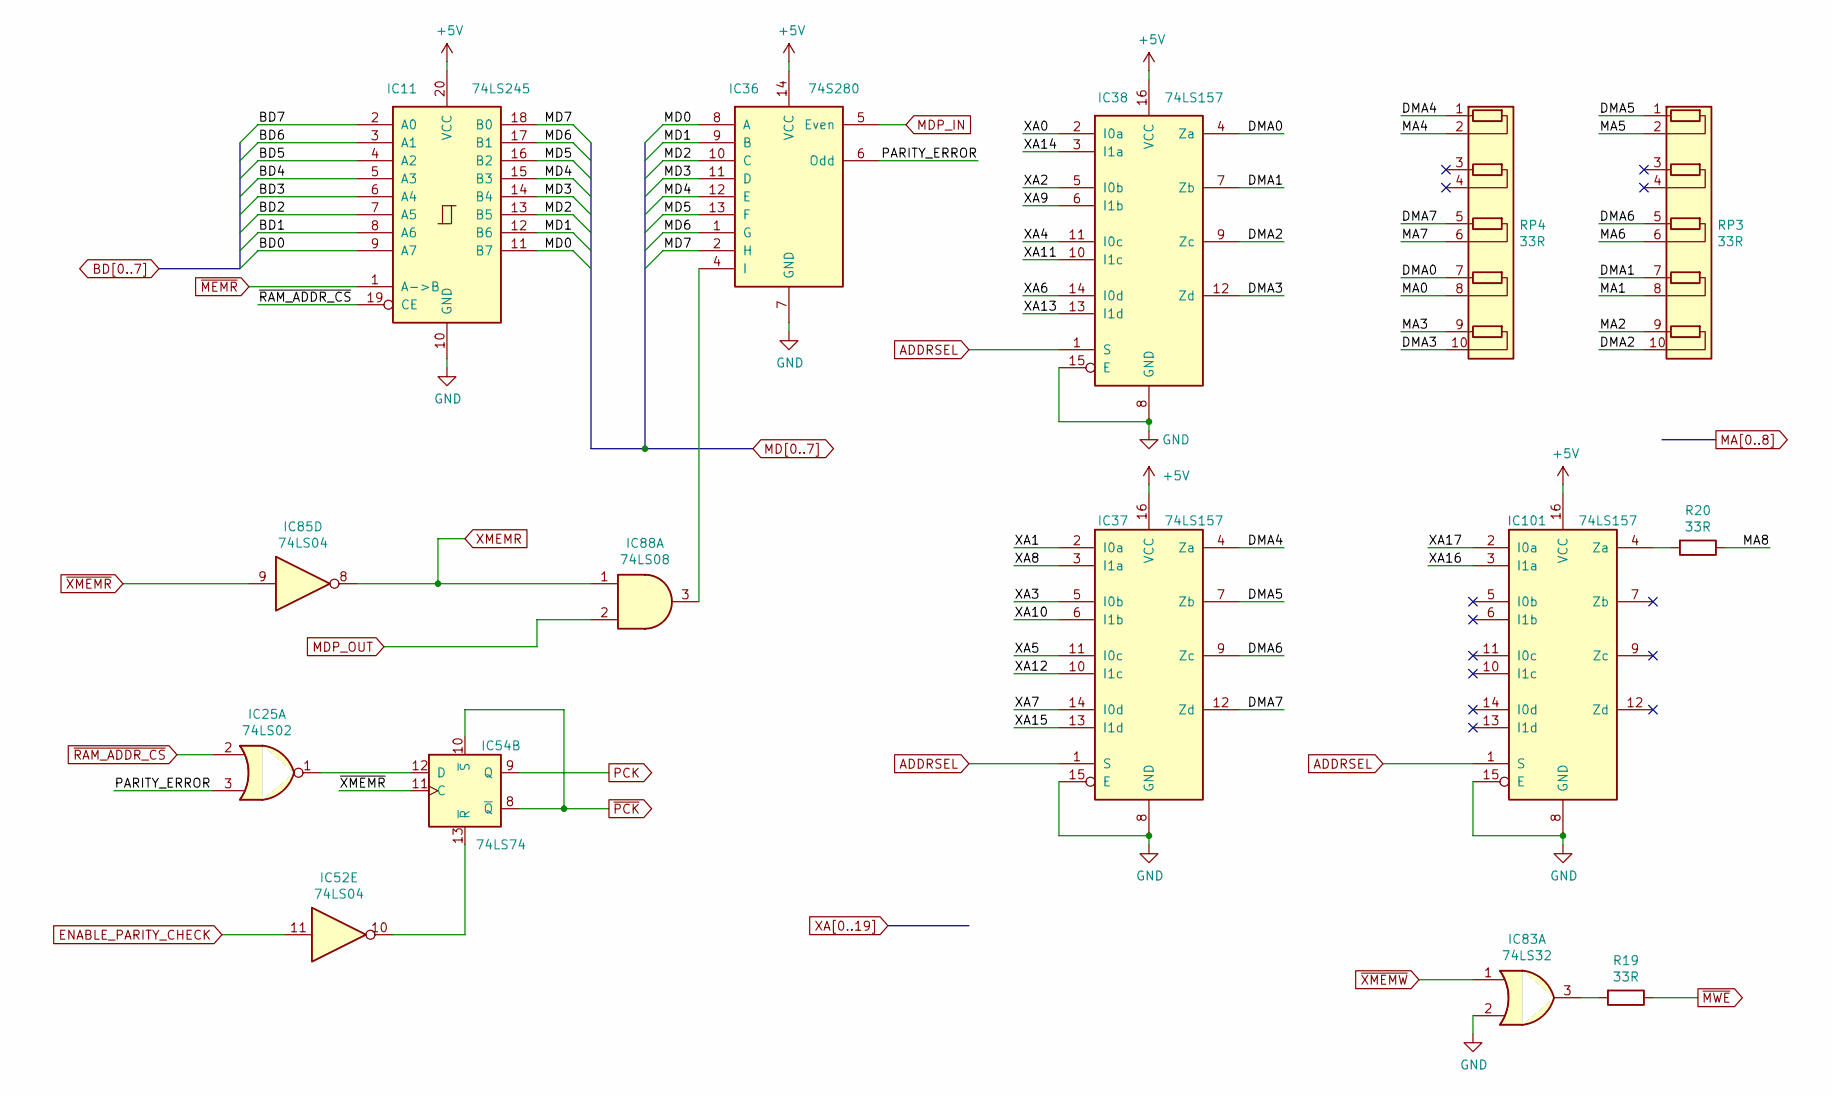
[picture p14: schematic memory-drive.sch]

Parts:
IC11: 74LS245
IC25: 74LS02
IC36: 74S280
IC37, IC38, IC101: 74LS157
IC52, IC85: 74LS04
IC54: 74LS74
IC83: 74LS32
IC88: 74LS08
R19, R20: 33R
RP3, RP4: 33R; R_Array_SIP10

Connections:
+5V: IC11.20 (VCC), IC36.14 (VCC), IC37.16 (VCC), IC38.16 (VCC), IC101.16 (VCC)
ADDRSEL: IC37.1 (S), IC38.1 (S), IC101.1 (S)
BD0: IC11.9 (A7)
BD1: IC11.8 (A6)
BD2: IC11.7 (A5)
BD3: IC11.6 (A4)
BD4: IC11.5 (A3)
BD5: IC11.4 (A2)
BD6: IC11.3 (A1)
BD7: IC11.2 (A0)
DMA0: IC38.4 (Za), RP4.7 (R4.1)
DMA1: IC38.7 (Zb), RP3.7 (R4.1)
DMA2: IC38.9 (Zc), RP3.10 (R5.2)
DMA3: IC38.12 (Zd), RP4.10 (R5.2)
DMA4: IC37.4 (Za), RP4.1 (R1.1)
DMA5: IC37.7 (Zb), RP3.1 (R1.1)
DMA6: IC37.9 (Zc), RP3.5 (R3.1)
DMA7: IC37.12 (Zd), RP4.5 (R3.1)
ENABLE_PARITY_CHECK: IC52.11
GND: IC11.10 (GND), IC36.7 (GND), IC37.8 (GND), IC37.15 (E), IC38.8 (GND), IC38.15 (E), IC83.2, IC101.8 (GND), IC101.15 (E)
MA0: RP4.8 (R4.2)
MA1: RP3.8 (R4.2)
MA2: RP3.9 (R5.1)
MA3: RP4.9 (R5.1)
MA4: RP4.2 (R1.2)
MA5: RP3.2 (R1.2)
MA6: RP3.6 (R3.2)
MA7: RP4.6 (R3.2)
MA8: R20.1
MD0: IC11.11 (B7), IC36.8 (A)
MD1: IC11.12 (B6), IC36.9 (B)
MD2: IC11.13 (B5), IC36.10 (C)
MD3: IC11.14 (B4), IC36.11 (D)
MD4: IC11.15 (B3), IC36.12 (E)
MD5: IC11.16 (B2), IC36.13 (F)
MD6: IC11.17 (B1), IC36.1 (G)
MD7: IC11.18 (B0), IC36.2 (H)
MDP_IN: IC36.5 (Even)
MDP_OUT: IC88.2
unnamed: IC25.1, IC54.12 (D)
unnamed: IC36.4 (I), IC88.3
unnamed: IC52.10, IC54.13 (~R)
unnamed: IC83.3, R19.2
unnamed: IC101.4 (Za), R20.2
PARITY_ERROR: IC25.3, IC36.6 (Odd)
PCK: IC54.9 (Q)
XA0: IC38.2 (I0a)
XA1: IC37.2 (I0a)
XA2: IC38.5 (I0b)
XA3: IC37.5 (I0b)
XA4: IC38.11 (I0c)
XA5: IC37.11 (I0c)
XA6: IC38.14 (I0d)
XA7: IC37.14 (I0d)
XA8: IC37.3 (I1a)
XA9: IC38.6 (I1b)
XA10: IC37.6 (I1b)
XA11: IC38.10 (I1c)
XA12: IC37.10 (I1c)
XA13: IC38.13 (I1d)
XA14: IC38.3 (I1a)
XA15: IC37.13 (I1d)
XA16: IC101.3 (I1a)
XA17: IC101.2 (I0a)
XMEMR: IC85.8, IC88.1
~MEMR~: IC11.1 (A->B)
~MWE~: R19.1
~PCK~: IC54.8 (~Q), IC54.10 (~S)
~RAM_ADDR_CS~: IC11.19 (CE), IC25.2
~XMEMR~: IC54.11 (C), IC85.9
~XMEMW~: IC83.1
