davefiddes/Wugo-PCII-System-Board/ram-decode.sch

## KiCad design ram-decode.sch (2020-07-20)

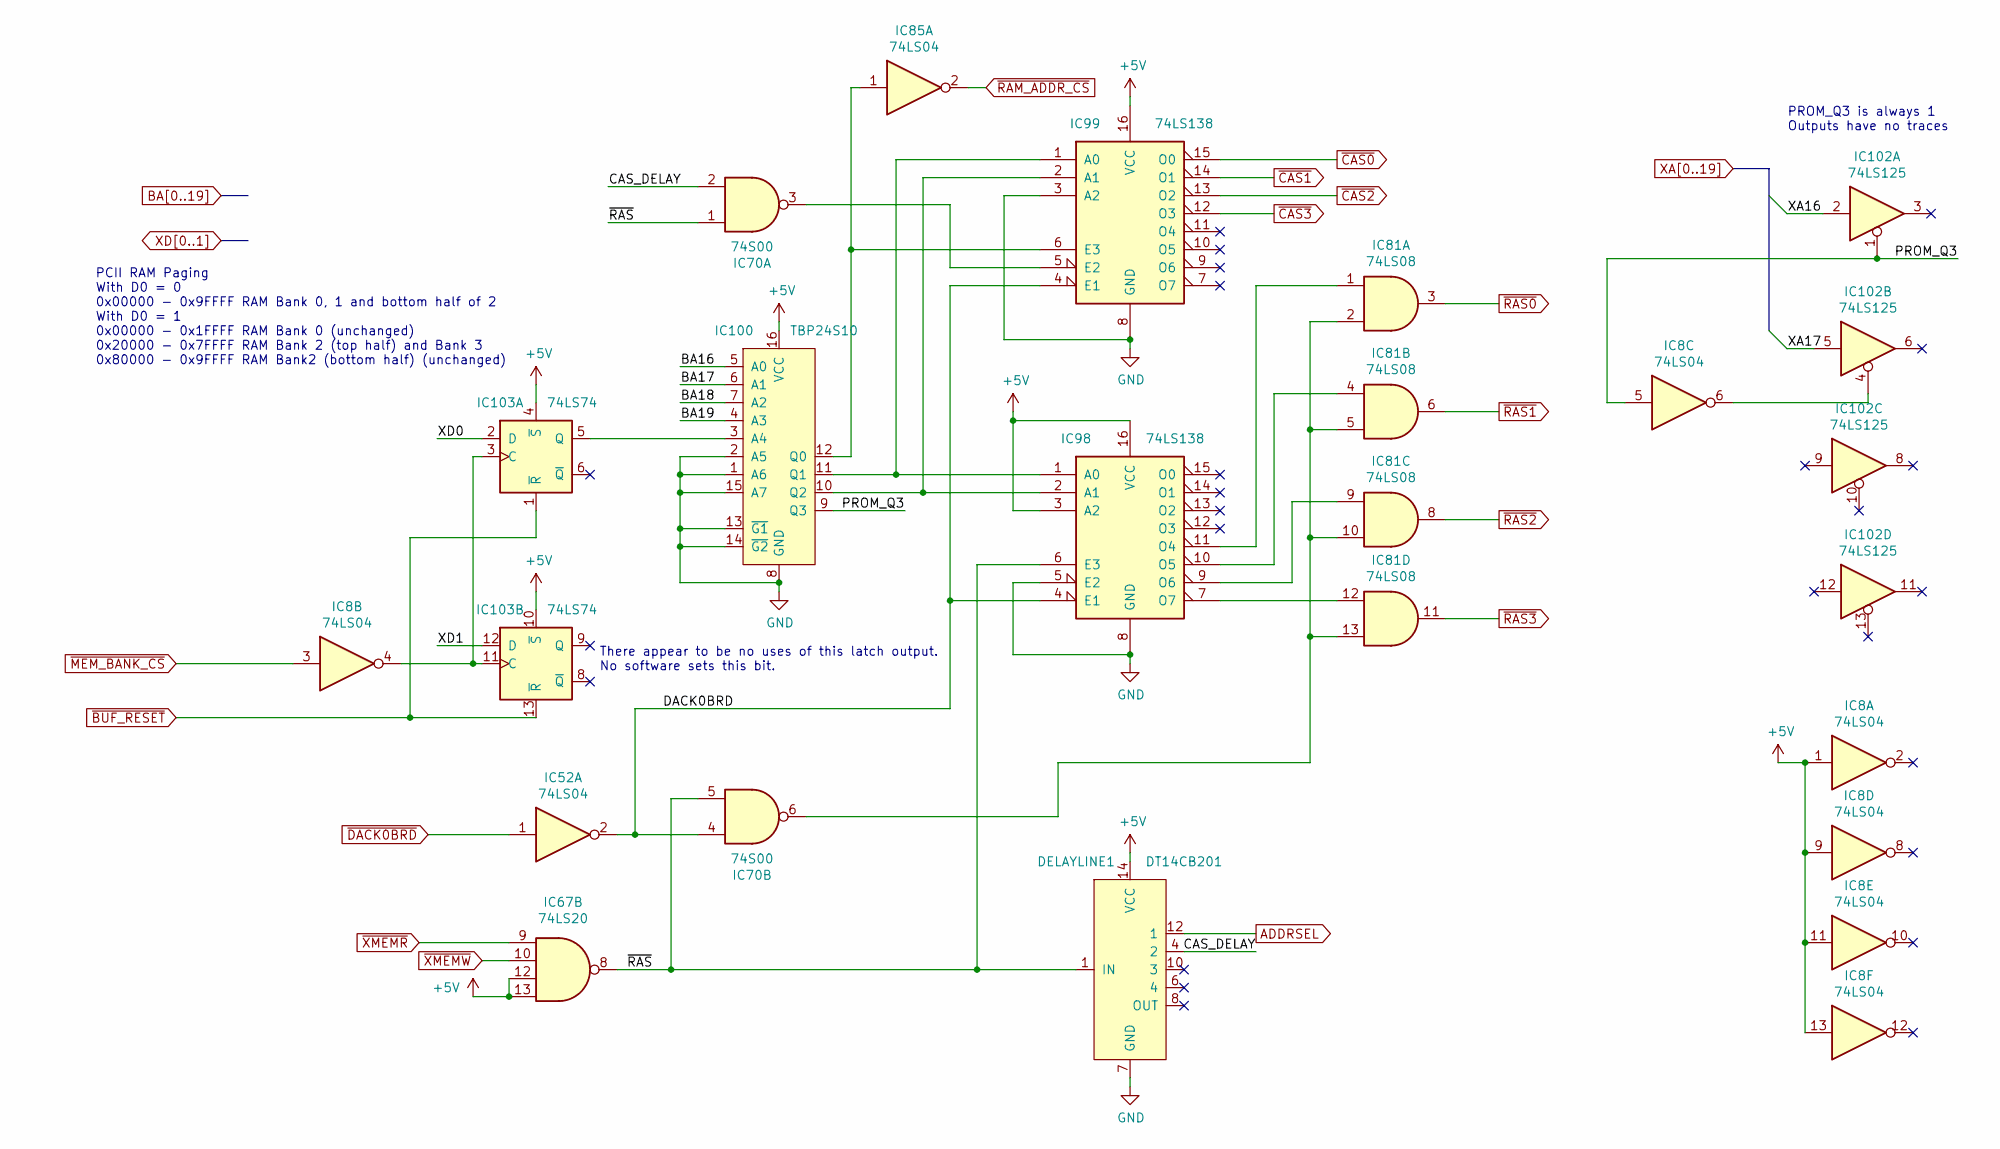
[picture p15: schematic ram-decode.sch]

Parts:
DELAYLINE1: DT14CB201
IC8, IC52, IC85: 74LS04
IC67: 74LS20
IC70: 74S00
IC81: 74LS08
IC98, IC99: 74LS138
IC100: TBP24S10
IC102: 74LS125
IC103: 74LS74

Connections:
+5V: DELAYLINE1.14 (VCC), IC8.1, IC8.9, IC8.11, IC8.13, IC67.12, IC67.13, IC98.3 (A2), IC98.16 (VCC), IC99.16 (VCC), IC100.16 (VCC), IC103.4 (~S), IC103.10 (~S)
ADDRSEL: DELAYLINE1.12 (1)
BA16: IC100.5 (A0)
BA17: IC100.6 (A1)
BA18: IC100.7 (A2)
BA19: IC100.4 (A3)
CAS_DELAY: DELAYLINE1.4 (2), IC70.2
DACK0BRD: IC52.2, IC70.4, IC98.4 (E1), IC99.4 (E1)
GND: DELAYLINE1.7 (GND), IC98.5 (E2), IC98.8 (GND), IC99.3 (A2), IC99.8 (GND), IC100.1 (A6), IC100.2 (A5), IC100.8 (GND), IC100.13 (~G1~), IC100.14 (~G2~), IC100.15 (A7)
unnamed: IC70.3, IC99.5 (E2)
unnamed: IC70.6, IC81.2, IC81.5, IC81.10, IC81.13
unnamed: IC81.1, IC98.11 (O4)
unnamed: IC81.4, IC98.10 (O5)
unnamed: IC81.9, IC98.9 (O6)
unnamed: IC81.12, IC98.7 (O7)
unnamed: IC100.3 (A4), IC103.5 (Q)
unnamed: IC98.2 (A1), IC99.2 (A1), IC100.10 (Q2)
unnamed: IC98.1 (A0), IC99.1 (A0), IC100.11 (Q1)
unnamed: IC85.1, IC99.6 (E3), IC100.12 (Q0)
unnamed: IC8.6, IC102.4
unnamed: IC8.4, IC103.3 (C), IC103.11 (C)
PROM_Q3: IC8.5, IC100.9 (Q3), IC102.1
XA16: IC102.2
XA17: IC102.5
XD0: IC103.2 (D)
XD1: IC103.12 (D)
~BUF_RESET~: IC103.1 (~R), IC103.13 (~R)
~CAS0~: IC99.15 (O0)
~CAS1~: IC99.14 (O1)
~CAS2~: IC99.13 (O2)
~CAS3~: IC99.12 (O3)
~DACK0BRD~: IC52.1
~MEM_BANK_CS~: IC8.3
~RAM_ADDR_CS~: IC85.2
~RAS0~: IC81.3
~RAS1~: IC81.6
~RAS2~: IC81.8
~RAS3~: IC81.11
~RAS~: DELAYLINE1.1 (IN), IC67.8, IC70.1, IC70.5, IC98.6 (E3)
~XMEMR~: IC67.9
~XMEMW~: IC67.10

Notes on the sheet:
There appear to be no uses of this latch output. No software sets this bit.
PCII RAM Paging With D0 = 0 0x00000 - 0x9FFFF RAM Bank 0, 1 and bottom half of 2 With D0 = 1 0x00000 - 0x1FFFF RAM Bank 0 (unchanged) 0x20000 - 0x7FFFF RAM Bank 2 (top half) and Bank 3 0x80000 - 0x9FFFF RAM Bank2 (bottom half) (unchanged)
PROM_Q3 is always 1 Outputs have no traces
