davefiddes/Wugo-PCII-System-Board/rom.sch

## KiCad design rom.sch (2020-07-20)

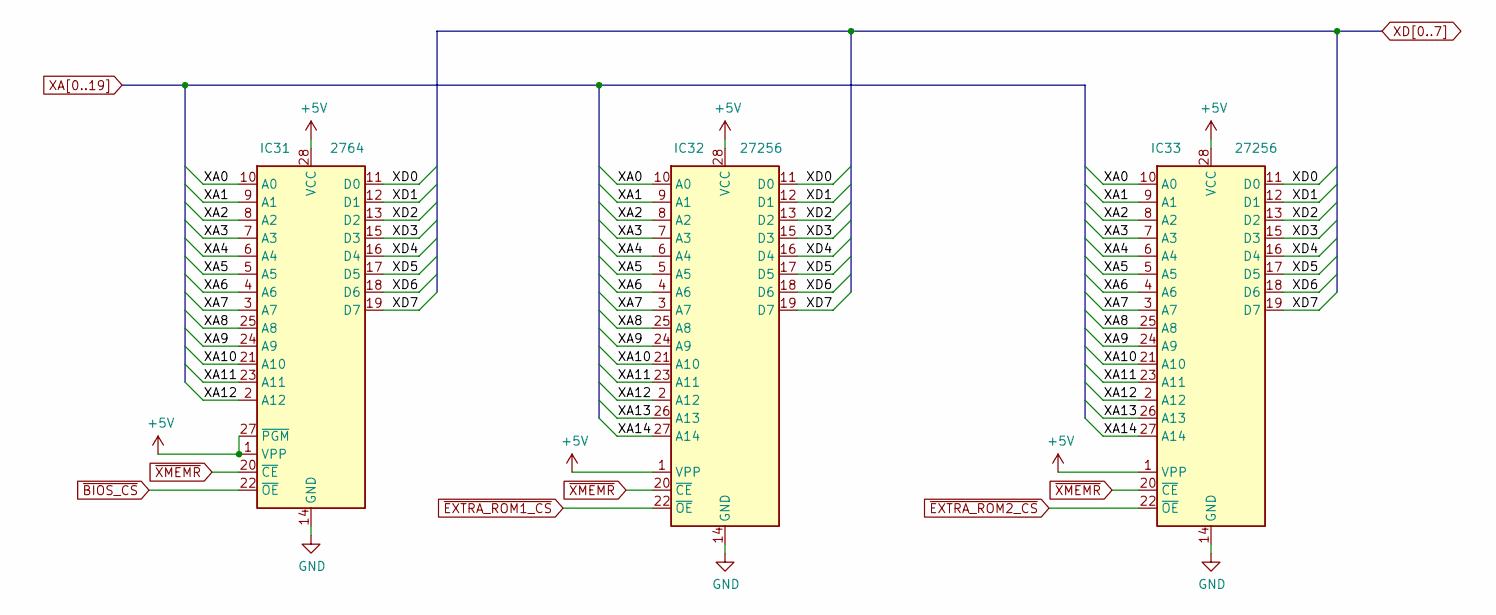
[picture p17: schematic rom.sch]

Parts:
IC31: 2764; DIP-28_W15.24mm
IC32, IC33: 27256; DIP-28_W15.24mm

Connections:
+5V: IC31.1 (VPP), IC31.27 (~PGM), IC31.28 (VCC), IC32.1 (VPP), IC32.28 (VCC), IC33.1 (VPP), IC33.28 (VCC)
GND: IC31.14 (GND), IC32.14 (GND), IC33.14 (GND)
XA0: IC31.10 (A0), IC32.10 (A0), IC33.10 (A0)
XA1: IC31.9 (A1), IC32.9 (A1), IC33.9 (A1)
XA2: IC31.8 (A2), IC32.8 (A2), IC33.8 (A2)
XA3: IC31.7 (A3), IC32.7 (A3), IC33.7 (A3)
XA4: IC31.6 (A4), IC32.6 (A4), IC33.6 (A4)
XA5: IC31.5 (A5), IC32.5 (A5), IC33.5 (A5)
XA6: IC31.4 (A6), IC32.4 (A6), IC33.4 (A6)
XA7: IC31.3 (A7), IC32.3 (A7), IC33.3 (A7)
XA8: IC31.25 (A8), IC32.25 (A8), IC33.25 (A8)
XA9: IC31.24 (A9), IC32.24 (A9), IC33.24 (A9)
XA10: IC31.21 (A10), IC32.21 (A10), IC33.21 (A10)
XA11: IC31.23 (A11), IC32.23 (A11), IC33.23 (A11)
XA12: IC31.2 (A12), IC32.2 (A12), IC33.2 (A12)
XA13: IC32.26 (A13), IC33.26 (A13)
XA14: IC32.27 (A14), IC33.27 (A14)
XD0: IC31.11 (D0), IC32.11 (D0), IC33.11 (D0)
XD1: IC31.12 (D1), IC32.12 (D1), IC33.12 (D1)
XD2: IC31.13 (D2), IC32.13 (D2), IC33.13 (D2)
XD3: IC31.15 (D3), IC32.15 (D3), IC33.15 (D3)
XD4: IC31.16 (D4), IC32.16 (D4), IC33.16 (D4)
XD5: IC31.17 (D5), IC32.17 (D5), IC33.17 (D5)
XD6: IC31.18 (D6), IC32.18 (D6), IC33.18 (D6)
XD7: IC31.19 (D7), IC32.19 (D7), IC33.19 (D7)
~BIOS_CS~: IC31.22 (~OE)
~EXTRA_ROM1_CS~: IC32.22 (~OE)
~EXTRA_ROM2_CS~: IC33.22 (~OE)
~XMEMR~: IC31.20 (~CE), IC32.20 (~CE), IC33.20 (~CE)
