davefiddes/Wugo-PCII-System-Board/rtc.sch

## KiCad design rtc.sch (2020-07-20)

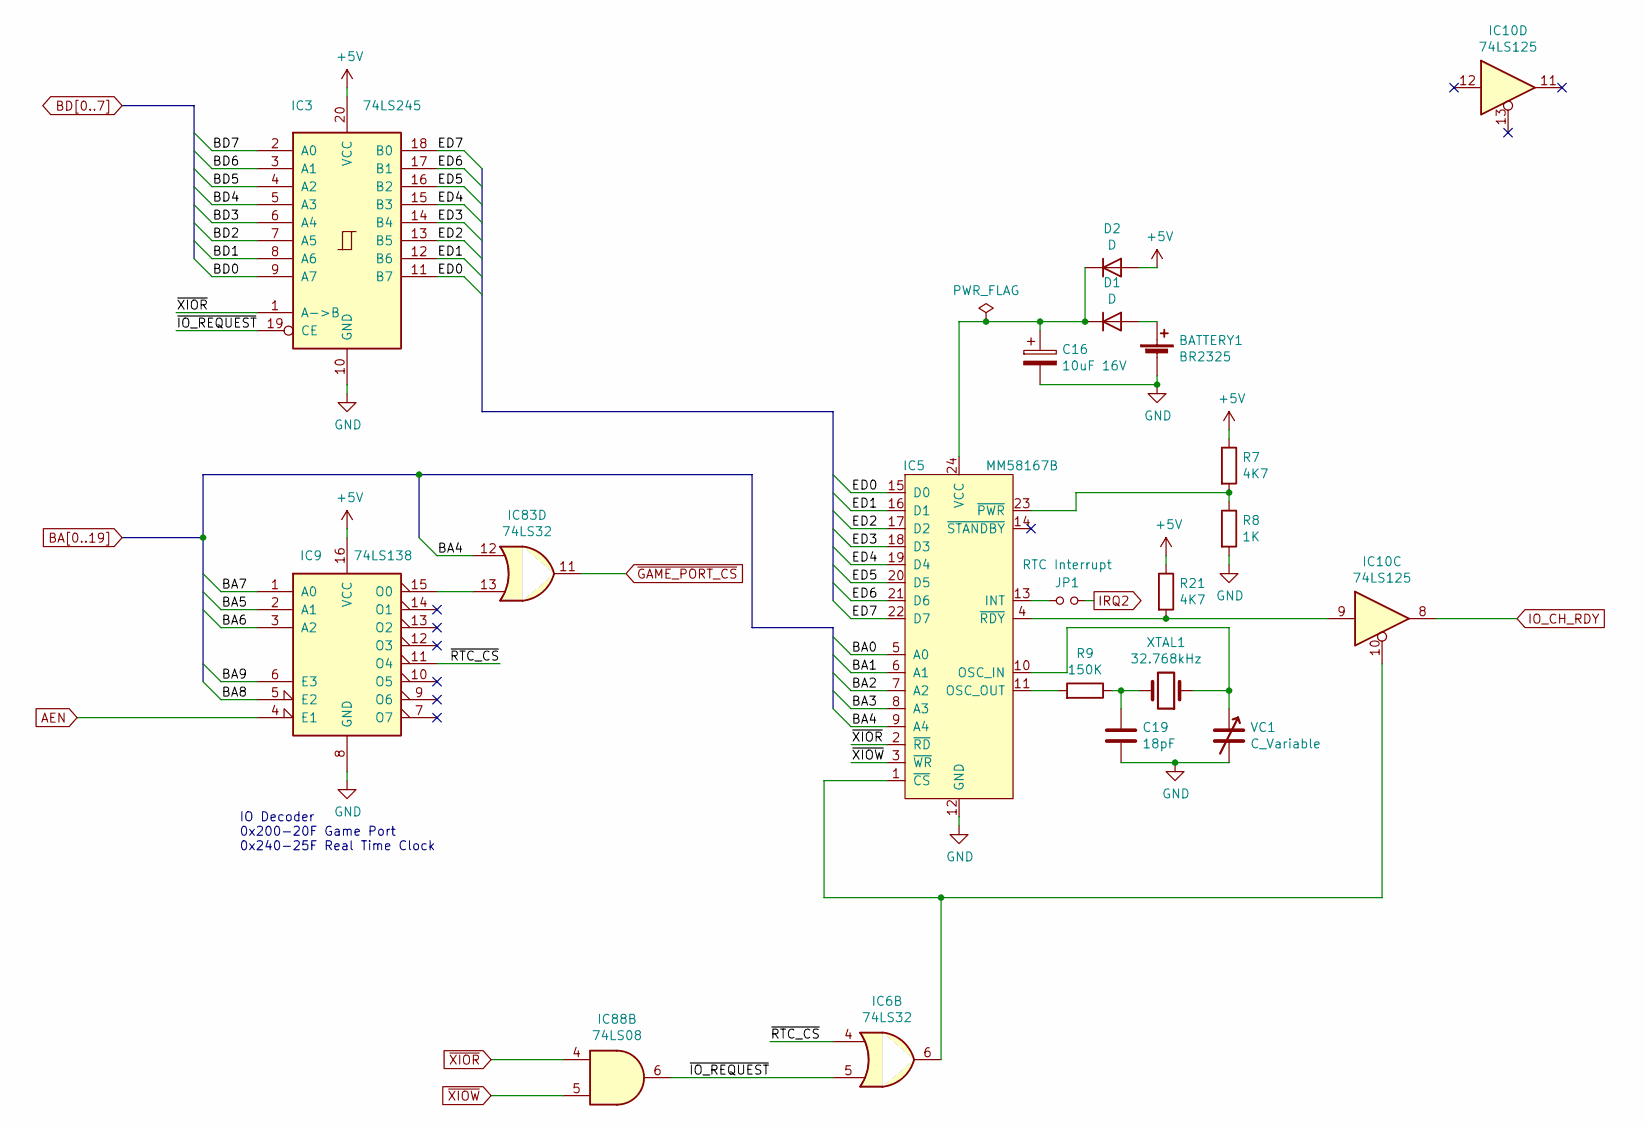
[picture p18: schematic rtc.sch]

Parts:
BATTERY1: BR2325
C16: 10uF 16V
C19: 18pF
D1, D2: D
IC3: 74LS245
IC5: MM58167B
IC6, IC83: 74LS32
IC9: 74LS138
IC10: 74LS125
IC88: 74LS08
JP1: RTC Interrupt
R7, R21: 4K7
R8: 1K
R9: 150K
VC1: C_Variable
XTAL1: 32.768kHz

Connections:
+5V: D2.2 (A), IC3.20 (VCC), IC9.16 (VCC), R7.1, R21.1
AEN: IC9.4 (E1)
BA0: IC5.5 (A0)
BA1: IC5.6 (A1)
BA2: IC5.7 (A2)
BA3: IC5.8 (A3)
BA4: IC5.9 (A4), IC83.12
BA5: IC9.2 (A1)
BA6: IC9.3 (A2)
BA7: IC9.1 (A0)
BA8: IC9.5 (E2)
BA9: IC9.6 (E3)
BD0: IC3.9 (A7)
BD1: IC3.8 (A6)
BD2: IC3.7 (A5)
BD3: IC3.6 (A4)
BD4: IC3.5 (A3)
BD5: IC3.4 (A2)
BD6: IC3.3 (A1)
BD7: IC3.2 (A0)
ED0: IC3.11 (B7), IC5.15 (D0)
ED1: IC3.12 (B6), IC5.16 (D1)
ED2: IC3.13 (B5), IC5.17 (D2)
ED3: IC3.14 (B4), IC5.18 (D3)
ED4: IC3.15 (B3), IC5.19 (D4)
ED5: IC3.16 (B2), IC5.20 (D5)
ED6: IC3.17 (B1), IC5.21 (D6)
ED7: IC3.18 (B0), IC5.22 (D7)
GND: BATTERY1.2 (-), C16.2, C19.2, IC3.10 (GND), IC5.12 (GND), IC9.8 (GND), R8.2, VC1.2
IO_CH_RDY: IC10.8
IRQ2: JP1.2
unnamed: BATTERY1.1 (+), D1.2 (A)
unnamed: C16.1, D1.1 (K), D2.1 (K), IC5.24 (VCC)
unnamed: C19.1, R9.1, XTAL1.2
unnamed: IC5.10 (OSC_IN), VC1.1, XTAL1.1
unnamed: IC5.11 (OSC_OUT), R9.2
unnamed: IC5.13 (INT), JP1.1
unnamed: IC5.23 (~PWR~), R7.2, R8.1
unnamed: IC5.4 (~RDY~), IC10.9, R21.2
unnamed: IC5.1 (~CS~), IC6.6, IC10.10
unnamed: IC9.15 (O0), IC83.13
~GAME_PORT_CS~: IC83.11
~IO_REQUEST~: IC3.19 (CE), IC6.5, IC88.6
~RTC_CS~: IC6.4, IC9.11 (O4)
~XIOR~: IC3.1 (A->B), IC5.2 (~RD~), IC88.4
~XIOW~: IC5.3 (~WR~), IC88.5

Notes on the sheet:
IO Decoder 0x200-20F Game Port 0x240-25F Real Time Clock
