davefiddes/Wugo-PCII-System-Board/timer.sch

## KiCad design timer.sch (2020-07-20)

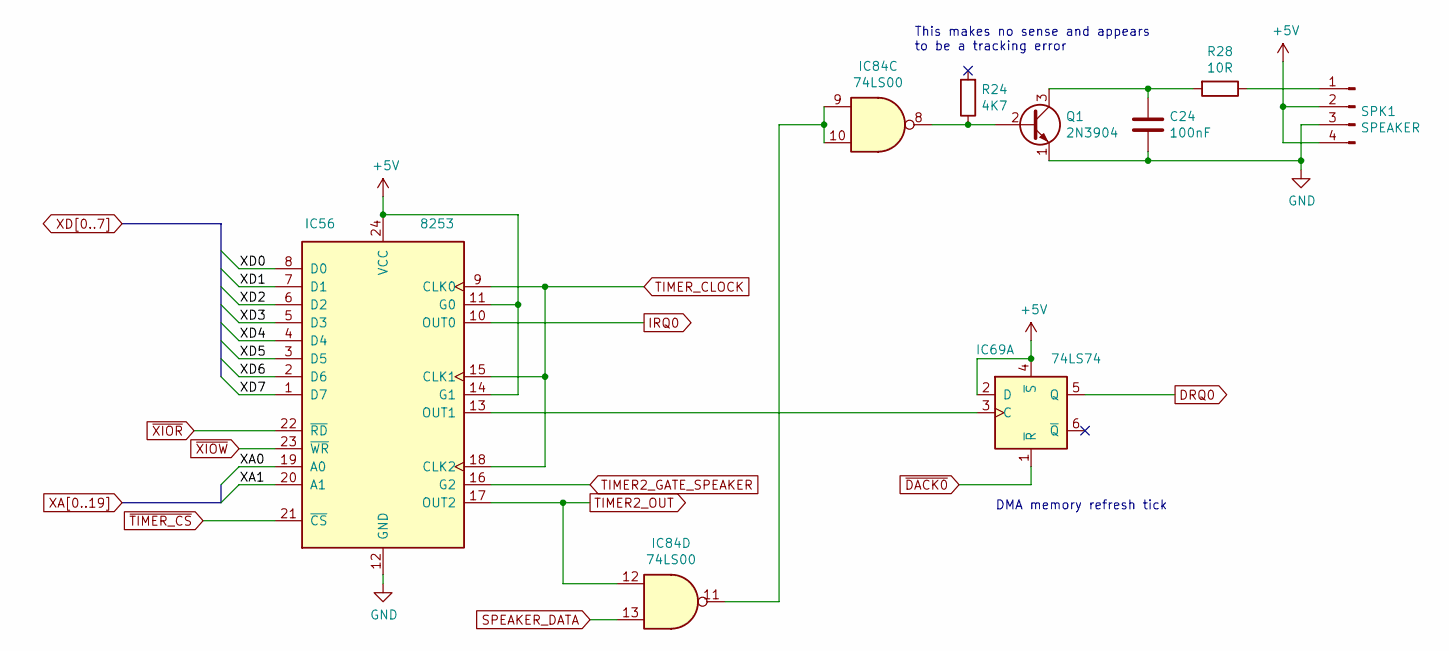
[picture p19: schematic timer.sch]

Parts:
C24: 100nF
IC56: 8253; DIP-24_W15.24mm
IC69: 74LS74
IC84: 74LS00
Q1: 2N3904; TO-92_Inline
R24: 4K7
R28: 10R
SPK1: SPEAKER

Connections:
+5V: IC56.11 (G0), IC56.14 (G1), IC56.24 (VCC), IC69.2 (D), IC69.4 (~S), SPK1.2, SPK1.4
DRQ0: IC69.5 (Q)
GND: C24.2, IC56.12 (GND), Q1.1 (E), SPK1.3
IRQ0: IC56.10 (OUT0)
unnamed: C24.1, Q1.3 (C), R28.2
unnamed: IC56.13 (OUT1), IC69.3 (C)
unnamed: IC84.8, Q1.2 (B), R24.1
unnamed: IC84.9, IC84.10, IC84.11
unnamed: R28.1, SPK1.1
SPEAKER_DATA: IC84.13
TIMER2_GATE_SPEAKER: IC56.16 (G2)
TIMER2_OUT: IC56.17 (OUT2), IC84.12
TIMER_CLOCK: IC56.9 (CLK0), IC56.15 (CLK1), IC56.18 (CLK2)
XA0: IC56.19 (A0)
XA1: IC56.20 (A1)
XD0: IC56.8 (D0)
XD1: IC56.7 (D1)
XD2: IC56.6 (D2)
XD3: IC56.5 (D3)
XD4: IC56.4 (D4)
XD5: IC56.3 (D5)
XD6: IC56.2 (D6)
XD7: IC56.1 (D7)
~DACK0~: IC69.1 (~R)
~TIMER_CS~: IC56.21 (~CS~)
~XIOR~: IC56.22 (~RD~)
~XIOW~: IC56.23 (~WR~)

Notes on the sheet:
DMA memory refresh tick
This makes no sense and appears to be a tracking error
