davefiddes/Wugo-PCII-System-Board/xbus-buffer.sch

## KiCad design xbus-buffer.sch (2020-07-20)

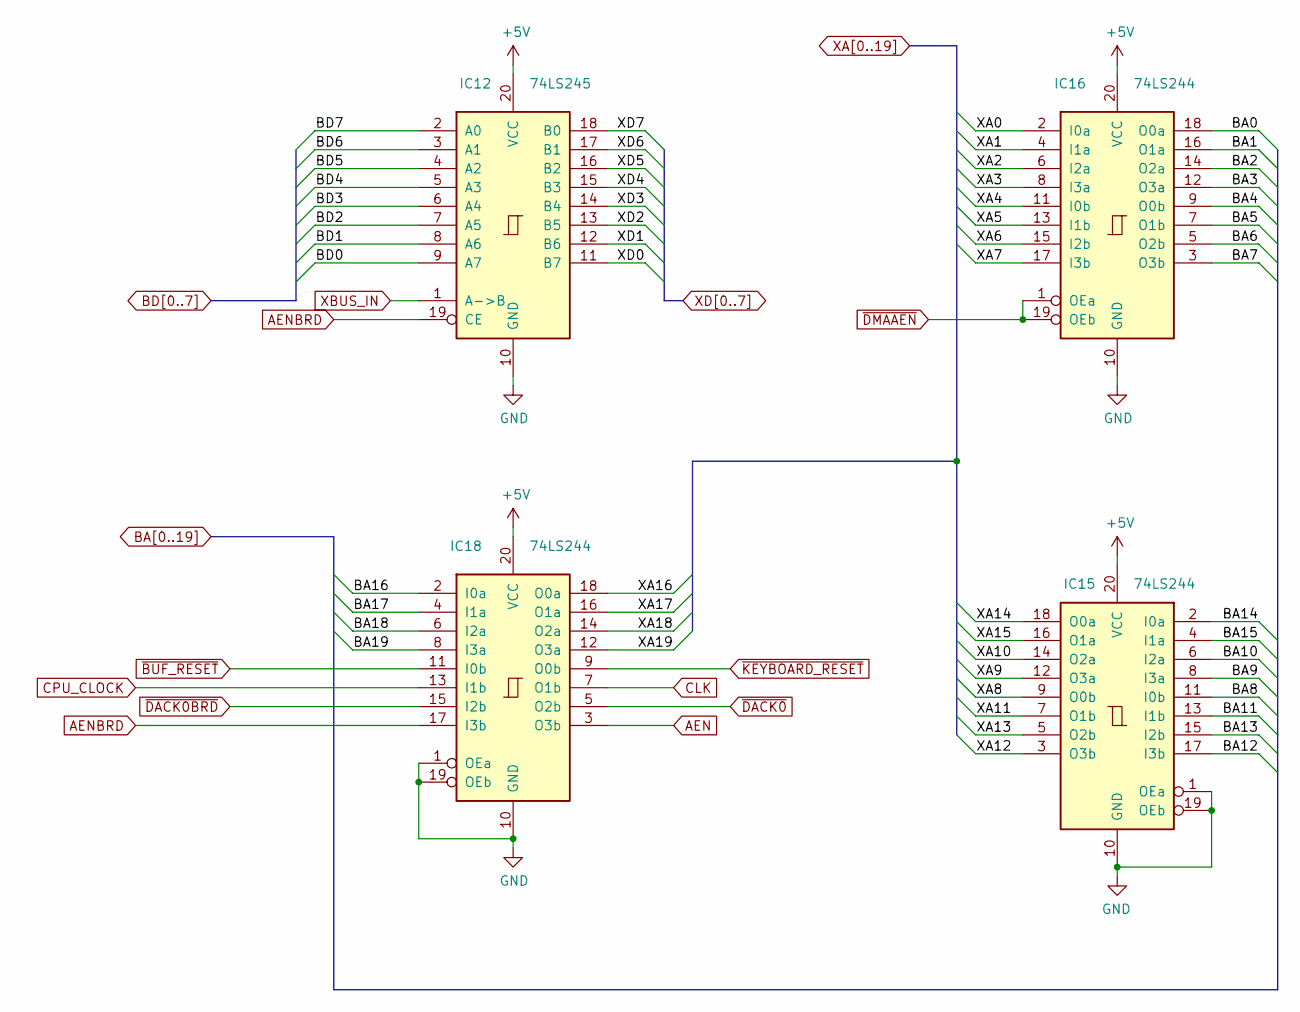
[picture p20: schematic xbus-buffer.sch]

Parts:
IC12: 74LS245
IC15, IC16, IC18: 74LS244

Connections:
+5V: IC12.20 (VCC), IC15.20 (VCC), IC16.20 (VCC), IC18.20 (VCC)
AEN: IC18.3 (O3b)
AENBRD: IC12.19 (CE), IC18.17 (I3b)
BA0: IC16.18 (O0a)
BA1: IC16.16 (O1a)
BA2: IC16.14 (O2a)
BA3: IC16.12 (O3a)
BA4: IC16.9 (O0b)
BA5: IC16.7 (O1b)
BA6: IC16.5 (O2b)
BA7: IC16.3 (O3b)
BA8: IC15.11 (I0b)
BA9: IC15.8 (I3a)
BA10: IC15.6 (I2a)
BA11: IC15.13 (I1b)
BA12: IC15.17 (I3b)
BA13: IC15.15 (I2b)
BA14: IC15.2 (I0a)
BA15: IC15.4 (I1a)
BA16: IC18.2 (I0a)
BA17: IC18.4 (I1a)
BA18: IC18.6 (I2a)
BA19: IC18.8 (I3a)
BD0: IC12.9 (A7)
BD1: IC12.8 (A6)
BD2: IC12.7 (A5)
BD3: IC12.6 (A4)
BD4: IC12.5 (A3)
BD5: IC12.4 (A2)
BD6: IC12.3 (A1)
BD7: IC12.2 (A0)
CLK: IC18.7 (O1b)
CPU_CLOCK: IC18.13 (I1b)
GND: IC12.10 (GND), IC15.1 (OEa), IC15.10 (GND), IC15.19 (OEb), IC16.10 (GND), IC18.1 (OEa), IC18.10 (GND), IC18.19 (OEb)
XA0: IC16.2 (I0a)
XA1: IC16.4 (I1a)
XA2: IC16.6 (I2a)
XA3: IC16.8 (I3a)
XA4: IC16.11 (I0b)
XA5: IC16.13 (I1b)
XA6: IC16.15 (I2b)
XA7: IC16.17 (I3b)
XA8: IC15.9 (O0b)
XA9: IC15.12 (O3a)
XA10: IC15.14 (O2a)
XA11: IC15.7 (O1b)
XA12: IC15.3 (O3b)
XA13: IC15.5 (O2b)
XA14: IC15.18 (O0a)
XA15: IC15.16 (O1a)
XA16: IC18.18 (O0a)
XA17: IC18.16 (O1a)
XA18: IC18.14 (O2a)
XA19: IC18.12 (O3a)
XBUS_IN: IC12.1 (A->B)
XD0: IC12.11 (B7)
XD1: IC12.12 (B6)
XD2: IC12.13 (B5)
XD3: IC12.14 (B4)
XD4: IC12.15 (B3)
XD5: IC12.16 (B2)
XD6: IC12.17 (B1)
XD7: IC12.18 (B0)
~BUF_RESET~: IC18.11 (I0b)
~DACK0BRD~: IC18.15 (I2b)
~DACK0~: IC18.5 (O2b)
~DMAAEN~: IC16.1 (OEa), IC16.19 (OEb)
~KEYBOARD_RESET~: IC18.9 (O0b)
