davefiddes/Wugo-PCII-System-Board/(commit log)

2020-05-20 Basic project created
    This is an empty Kicad 5.1 project to capture the schematics
    of a Wugo PC II System Board.
    [PCII-System-Board.sch]
2020-05-30 Initial attempt at buzzing out system board
    This is a first pass. It has most components and should only be missing:
    - ISA bus connectors
    - ROMs
    - RAM chips
    - PSU decoupling and power connector
    Most inter-sheet signals are local not global and no attempt
    has been made to run ERC.
    [PCII-System-Board.sch, clock.sch, cpu.sch, game-port.sch, interrupts-dma.sch, io-decode.sch, keyboard.sch, memory-drive.sch]
2020-06-13 Tidy up and map all signals
    This fixes up the schematic to:
    - Look presentable
    - Fix all labels connecting sheets
    - Tidy up all loose ends by either inspecting the PCB under
    magnification, measuring with an oscillosope or buzzing
    out with a meter
    - Pass ERC (with 1 exception due to incorrect circuitry around
    pin 33 on the FPU (~RQ~/~GT1~)
    [PCII-System-Board.sch, bus-arbitration.sch, clock.sch, cpu.sch, game-port.sch, interrupts-dma.sch, io-rom-decode.sch, isa-bus.sch]
2020-06-13 Utility to decode a dump of IC100
    This adds a utility to dump IC100 a TBP24S10 PROM used for
    memory decoding. For the 8088 address space it prints out
    which RAM bank is used and how this is affected by the
    custom PCII memory paging mechanism
    [PCII-System-Board-IC100-dump.csv]
2020-07-20 Fix clock frequencies
    This fixes the notes describing the clock frequencies having
    properly computed what they should be.
    [clock.sch]
2020-07-20 Add Revision 1.0 and copyright notice
    Add a simple copyright notice as this reverse engineered
    schematic is all my own work. The design is still copyright
    Wugo I believe.
    [PCII-System-Board.sch, bus-arbitration.sch, clock.sch, cpu.sch, game-port.sch, interrupts-dma.sch, io-rom-decode.sch, isa-bus.sch]
2020-07-20 Add some documentation
    This adds some documentation on the project, some pictures
    of the board and links to other archive material.
