davefiddes/Wugo-PCII-System-Board/(notices)

Notices in the files:
isa-bus.sch:
Schematics Copyright (c) 2020 David J. Fiddes
